dsohnaka/PTSG-WPMS-Formation/02_Reasoning_Traces/README.md

# Layer 2 — Reasoning Traces / 第2層——推論軌跡

**CC0.** The dialogues that produced Layer 1, published as Markdown (human) and JSON (LLM-ingestible). This profile sits between two other amanuenses (master: PTSG-CPU-Formation; customer: FPGA Spectrum Engine); their correspondence is part of the record.

| Trace | Date | Subject |
|---|---|---|
| `2026-09-07_wpms-formation-first-week` (.md / .json) | 2026-09-01 → 09-07 | Founding of the profile: charter and brief, the reading, the first rulings (W-R0–W-R9), the two discoveries that shaped the ISA (Stay value = packet length → two-stage register; integer ISA ⇒ program-owned MAC shift), deliverable 1, and the three-way correspondence. |
| `2026-09-27_mode-t-retraction-to-bundle-presentation` (.md / .json) | 2026-09-26 → 09-27 | Reading the customer's completed Layer 1; pricing CR5-L1, CR5-S1, CR5-I1; the two-window gap in F-F14; the model that sank Mode T; two remedies tested; bundle presentation with write windows; STP, BCP, the sweep sequencer; rulings W-R10 (amplitude) and W-R12–W-R17. |

Discrepancies filed upstream (four, all accepted and fixed 2026-09-03) and the customer's acceptance of deliverable 1 are recorded inside the trace.
