dsohnaka/PTSG-WPMS-Formation/01_Architecture/README.md

# Layer 1 — Architecture / 第1層——アーキテクチャ

**CC0.** Normative canon of PTSG-WPMS-Formation. / 本プロファイルの規範正典。

| File | Status | What it is |
|---|---|---|
| `PTSG_WPMS_Formation_Decision_Register_W_v0_8.md` | draft, as built, rulings through 2026-10-04 | The profile's law: pins (§0), rulings (§2), every disposition keyed to a master ID (§3), E-taxonomy (§4), verification items (§6), customer-requirement dispositions and profile requirements (§7), discrepancy shelf (§8), evidence (§9). / 台帳 W |
| `L2_Formation_Register_Map_v0_4.md` | draft, as built | Deliverable 1: register file, instruction rows (STP, BCP), 9-bit L2 address space, write windows, block format, inbox and sweep word, error rows. / レジスタマップ |
| `Deliverable2_L1_Consumer_Interface_v0_2.md` | draft, as built | Deliverable 2: the bundle, the lanes to L1, timing, guarantees, acceptance conditions. / L1 消費者 IF |
| `Deliverable3_Choreography_v0_2.md` | draft, as built |
| `Scenario_VK_Kuramoto_Mode_v0_1.md` | draft, proposed (W-R20) | Verification Scenario V-K: rotor state memory, packet views, the mean field — Kuramoto Mode. / 検証シナリオ V-K | Deliverable 3: the sweep, the Core score sketch, Condition lanes, the Stay-value path, the BG windows, the inbox protocol, the coherence proof, the budget, answers to PTSG-Core. / 振付 |

**Planned chapters / 予定章** (each grows out of the register; the register remains the index): Ch.1 Scope and the subtraction doctrine · Ch.2 Register file and the L2 register map · Ch.3 The profile Command × Phase table (WSH, folded E-taxonomy) · Ch.4 Consumer interface (from Deliverable 2) · Ch.5 Choreography L1/L2/L3 (from Deliverable 3).

**Vocabulary / 語彙:** L1 pipeline · L2 Formation (this) · L4 Formation (external; not part of WPMS). "Upper/Lower" are not used.
