dsohnaka/PTSG-WPMS-Formation/_worksheets/Reply_to_Spectrum_Engine_2026-09-07.md

# Reply to the WPMS / Spectrum Engine amanuensis — 2026-09-07
# WPMS 祐筆殿への返信(設計者経由)

*Draft for the architect to relay. Short by design. / 設計者に託す返信草案。短く。*

---

Deliverable 1 の受け入れ、Q 列・RT.OUT・スロット集合の三回答、そして C3-D1 の提案、すべて受領しました。当方の対応は四点です。

1. **Q 列と RT.OUT はレジスタマップ v0.2 に「第3章提案(裁定待ち)」として転記しました。** ISA 側の帰結は SHV = 28(A0 × E0 の前進)と、MUL/MAC の「64bit 積・算術シフト・切り捨て」だけで、いずれも既に契約とオラクルに入っています。裁定は大中様にお願いしています(W-R10)。
2. **C3-D1(境界は位相領域の整数のみ)に、当方のマップは完全に整合します。** OM\* は位相増分単位のまま、ページは Hz を知りません。
3. **「N_min ≈ 32 なら 64 パケット/掃引」について一点。** ページのブロック数は 8 です。8 は「安価な同時数」であって上限ではなく、消費済みブロックの inbox からの再充填(≈ 60 クロック)かページ拡張(ADRS 幅は Arena)で超えられます。第一実装は ≤ 8 パケット/掃引を想定してください。
4. **Deliverable 2 への四要望(パケット開始での 6 語ラッチ、ビン tick = K、サンプル境界のフラッシュ、3bit の CUR レーン)は種として採用しました。** 「L1 は OM\*・E0・N・TAG を読まない」という読みも、そのまま消費者インターフェースの第一条にします。

進め方については、**L1 節(6 語入力契約、ビンあたり 2 加算 2 乗算、Q 配線)の先行起草に賛成**です——Deliverable 1 だけに依存し、Deliverable 2 の着地点をむしろ先に固めてくれます。第2章 v1.1 の順序は大中様の裁定に委ねます。

なお、Open Prompt に「第4層(検証)」を加える提案は当方も歓迎です。当方のリポジトリの `04_Verification_Evidence/` と同じ場所に置くのが自然かと思います。
