dsohnaka/PTSG-WPMS-Formation/04_Verification_Evidence/reports/discrepancies.md

# Discrepancies — silicon phase / 食い違い台帳——シリコン化段階

*CC0 · Layer 4 register of disagreements found while executing `SILICON_BRIEF_2026-09-27.md`. Opened in Phase 0 (2026-09-27).*
*Rule (brief §6, CLAUDE.md): every row records what the texts say, what was found, and a proposed disposition — **filed, not fixed**. No Layer 1 document, golden model or frozen Core source has been edited to resolve any row. The architect rules.*

*規則（指示書 §6）: 各行は「文書が言うこと・見つけたこと・処置案」を記す——**記録のみ、修正なし**。いずれの行についても、第1層文書・黄金モデル・凍結 Core は一切編集していない。裁定はアーキテクト。*

Evidence classes: **ORACLE** (Python model) · **RTL-SIM** (Icarus) · **SILICON** (DE10-nano). "Reading" = found by reading the RTL/texts, not yet exercised.

---

## Summary / 一覧

| ID | Item | Texts say | Found | Proposed disposition | Class · state |
|---|---|---|---|---|---|
| **SD-01** | Band on the issue port (brief known #1) | master Ch.5 §5.2 lane 1, §5.3: the issue carries {mode, sub-op, operand, **band**} | `ptsg_core.v` RH030 exports `ext_op_valid`, `ext_op_subopcode[3:0]`, `ext_op_sub_operand[7:0]`, `ext_op_data[15:0]`, `ext_op_ready`; **no band** (`window_open`, `in_queued_band` internal) | E2 stays validator-only in the silicon phase (brief, Phase 2); band export is a Core-office item at its checkpoint; no Core change | Reading · open |
| **SD-02** | FG silence of the issue port (IF-3) | master Ch.5 §5.3 **IF-3**: C3-F23 halts any Global in FG, so the issue port never fires with band = FG and E1 is enforced by the Core | The RTL's FG trap covers only internal Base Set / Return / Call / Loop / Prog End. An **external-mode Global in FG is issued** (`ext_op_valid` has no window term) and advances at full clock, no HALT | Architect to rule: C3-F23 covers mode ≥ 1 (Core halts them at a checkpoint) **or** IF-3 is amended (E1 validator-only, like E2) | Reading · open |
| **SD-03** | SSS source (brief known #2) | master Ch.2 §2.6b, §2.9 (source ID 6); Ch.5 §5.2 lane 4, §5.4, **INT-R4**: Stay Start State + window-start event observable; Map v0.3 §2 | `stay_start_state` is internal ("no Core-level external visibility", C3-F25); **no port, no window-start event**; internal Globals (incl. Stay Set) are not issued on the ext bus | Phase 2 records a documented substitute for source ID 6; INT-R4 stays open with the Core's office. No WPMS program reads SSS today. *Phase 2 substitute: input `tap_sss[11:0]` of `wpms_formation.v`, driven in Phase 3 by the L2 top with the window label it latches at Stay Set* *Phase 3: the sequencer latches the Stay Set's address at every Stay Set (the value the Core's `stay_start_state` takes, C3-F25) and drives `tap_sss` with it from the window's first instruction on.* | Reading · open (substitute in place, Phase 3) |
| **SD-04** | Gap-free data-driven re-entry, R2 (brief known #3) | W v0.7 **W-R17** (R2 preferred); D3 §3 (backward transfer at timeup, or a loop count as data); Core commitment g = 0 | A queued Loop never performs the indirect read (`need_ind_loop` excludes the Q band; queued Loop(0) = zero iterations, C4-V1); the Q band admits one SN reservation (C3-F26; a second HALTs, T21). A queued Base Set + Loop gives a gap-free backward re-entry **with a literal count only** | Preliminary: no data-driven gap-free R2 in the Core as built. Phase 3 confirms by simulation, reports the Hook A options, proceeds with R1 (brief). No Core change *Phase 3 (`r2_probe.py`, RTL-SIM): queued Base Set + queued Loop 3 re-enters the whole window gap-free (Stay Set to Stay Set 32, 32, 32); queued Loop 0 plays once and makes no indirect read. R2 not built; Hook A answer in the Phase 3 report.* *2026-09-29: no INT-R1 request to the Core's office for now — the dispatch form already gives g = 0 and is the standard score; LoopVal stays on the indirect-read bus for a future data-driven loop.* | **Ruled 2026-09-29**: INT-R1 not requested now; R2 not built · closed |
| **SD-05** | Forward conditional at timeup (R1) and the NONEMPTY check vs Core Branch law | D3 §3: R1 "forward conditional: MORE → PKT(q+1), else → HK; needs only forward transfers"; sketch "Branch +→HK, lane NONEMPTY, false → HK [1 clock]" | Core Branch: Condition true → no branch (C2-F5); **taken → auto-save** into the holding register (C2-F6); a second save while it is occupied goes through **S_PUSH and waits for `stack_ack`** (C3-T6). Queued Branch **not taken resumes at Branch + 1** (T16), inside the Q region, not at Stay + 1 | Phase 3 designs the score around these laws and measures g; architect ruling may be needed on the queued-Branch not-taken resume address (§3.4b Branch Q row). Not a Core change. *Phase 2: both consequences reproduced by the score round trip (`score_rt.py` RT-1, RT-3)* *Phase 3: the score avoids both consequences — dispatch form (R1-D): no conditional transfer at all (queued Jumps, entry chosen in housekeeping by a background computed dispatch); branch form (R1-B): foreground Branch after each Stay (g = 1) and a foreground Reset closing housekeeping.* *2026-09-29: the dispatch form is the standard score for Phases 4–6 (ruling); it makes no conditional transfer, so neither consequence arises in it.* | RTL-SIM · open (worked around; not met by the standard score) |
| **SD-06** | Formation error strobe (lane 8, INT-R2) | master Ch.5 §5.2 lane 8, §5.8: the strobe "rides the Core's external error/halt input" (**INT-R2**); Map v0.3 §8: EW2–EW6, E4, E5 → Error HALT | `ptsg_core.v` has `error_flag` (output) only; **no external error/halt input** | Phase 2 picks insertion or Condition per C3-F24 and documents it (brief); INT-R2 stays open. *Phase 2 chose insertion: `insert_req` → `TRAP_ADDR`, where the score places a foreground Prog End (C3-F23 → C3-F24 HALT); Core wiring and latency measured in Phase 3* | **Ruled 2026-09-28**: insertion approved; L1 is silenced at once by the Formation's `error_flag`, without waiting for the Core's HALT (Phase 3) · INT-R2 stays open. *Phase 4: an error in the first housekeeping window after reset left JumpVal at its power-up 0, the dispatch went to 0x000 inside the open window and the deferred insertion was never taken (no HALT; L1 silent all the same). Fixed on the Formation side: JumpVal powers up at the score's TAIL_0 (`wpms_formation.v` RH003, `wpms_l2_top.v` RH002); now HALT 11 clocks after the flag* |
| **SD-07** | Width of I | Map v0.3 §1, §2: quartet K / I / SN / SSS is **W12** | Core `LOOP_W` = **16** (architect ruling 2026-07-07); `loop_counter[15:0]`; master Ch.2 §2.2 "I … loop-counter width" | Phase 2 reads I as 16 bits, zero-extended; Map to be aligned by ruling | Reading · open |
| **SD-08** | Register W v0.7 §2.2 editorial | §2.2 "Open: None." | A stray table fragment (file lines 80–86) repeats W-R12…W-R17 in their v0.6 "open" form; its W-R17 row ("R1 or R2 — the Core's choice") contradicts §2.1 | Editorial cleanup at the next version; no effect on the build | Reading · open |
| **SD-09** | Customer Appendix 5.B mask presets | Ch.5 §5.4.2 "bit 16 = RT.OUT"; §5.6.2 COMMIT[b] [16]; App. 5.B "RETUNE 0x9E3B … + RT.OUT", "RESEED 0x9FFF … + RT.OUT" | Neither value has bit 16 set (with it: 0x19E3B, 0x19FFF) | Customer to correct value or wording (via the architect, PR-5 style); the Phase 5 host script sets bit 16 explicitly | Reading · open |
| **SD-10** | Stale header comments in `ptsg_core.v` not covered by the RH029/030 patch | Core Ch.3 §3.2 (C4-F10 corrected: counter counts On-Tick from Stay Set through the window); Core README tie table | Header Tie line "C4-T4 … the stay counter ticks only during the wait" contradicts C4-F10; "Deliberate simplifications" still says post-Prog-End commands other than Loop execute immediately (superseded by RH014–RH019) and that imem is an asynchronous read (superseded by `ptsg_imem` NEG) | For the Core's office at its checkpoint (comments only). **Not** changed in the working copy — outside the brief's patch list | Reading · open |
| **SD-11** | Registered timing signals vs "packet_start = Stay Set ∧ TS_PKT" | D2 §2–§3: `packet_start` = Core Stay Set ∧ TS_PKT, K = 0 **on that clock**; `bin_valid` = TS_PKT held through the Stay | `timing_signals` is a registered Core output: a word's D16–D31 appears **one clock after** the word executes (FG Stay Set: `timing_signals <= tsig`). During the Stay Set clock the bus still shows the previous word's bits; TS_PKT alone therefore rises one clock late at the first packet and falls one clock late after the last (the housekeeping Stay Set clock) | Phase 3 derives `packet_start`/`bin_valid` so that they align with K = 0 on the Stay Set clock (e.g. from `state_number` against the score's packet addresses, or a documented one-clock shift of L1) and states the choice *Phase 3: resolved by a uniform one-clock L1 face — bin_valid(c) = TS_PKT(c), K(c−1), packet_start one clock after the Stay Set; every packet of the sweep cosimulation has N bins with K = 0 … N−1.* | RTL-SIM · resolved in the L2 top (Phase 3) |
| **SD-12** | Packet floor on the Core: 29 (nominal) vs 30 (RTL-SIM) — *Phase 1* | D3 §6.1, Map v0.3 §9, `wpms_packet.pfasm` header, `sweep_sim.py` output: 25 window instructions + **4** Core clocks = 29, rounded up to N_MIN = 32 | On the Core copy, a windowed Stay never times up in its execute clock (RH028's same-clock timeup is for bare Stays only), so Stay Set · 25 · Prog End · queued transfer · Stay needs **one S_WAIT clock more**: period = max(N, **30**), K = 0…N−1, g = 0 (SV-5b) | The RTL number replaces the nominal in the reports (not in Layer 1, which changes by ruling); N_MIN = 32 still holds with 2 clocks of margin. Phase 3 re-measures with the real window and score (an R2 body with Base Set(Q) + Loop(Q) would add one more clock: 31, by reading) *Phase 3, with the real window and score: floor 30 in the dispatch form (N = 28, 29, 30 → 30; 31 → 31), max(N, 29) + 1 in the branch form.* | RTL-SIM · open (re-measured, Phase 3) |
| **SD-13** | E8 for a left SFT that leaves 32 bits — *Phase 2* | Register W v0.7 §4 row E8 "MUL/MAC only (W-F30)"; W-F30 "E8 only for MUL/MAC"; Map v0.3 §3 1·7 SFT "master semantics", §8 E8 "MUL/MAC overflow"; master Ch.3 E8 "arithmetic overflow … never lost" | The golden model raises **E8 for SFT** too: `Machine.run` SFT → `sat(accm << -n)` (line 178). The hardware follows the model (golden, never edited to make hardware pass); mutant M17 shows the cosimulation tells the two apart | Architect to rule the reading of "only": (a) "not ADD/SUB" — SFT keeps the master's never-lost rule, texts read "MUL/MAC/SFT" (model and hardware stand); (b) SFT left shifts wrap or saturate silently — model and hardware change together | **Ruled 2026-09-28: (a)** — E8 on SFT overflow stands; the texts to say MUL/MAC/SFT at their next version (Layer 1 not edited here) |
| **SD-14** | Lane select of a foreground Branch is one word late — *Phase 2* | Deliverable 3 §4: the Condition lane is "selected by two timing-signal bits of the word being executed (or held)"; §3 sketch: SLEEP `Branch 0` (STROBE) then `Branch +→HK` (NONEMPTY) | `timing_signals` is registered (as SD-11): in the clock a foreground Branch evaluates `condition`, the bus still carries the **previous** word's bits. `score_rt.py` RT-2 (P = 2): the NONEMPTY Branch at 0x002 is evaluated with SLEEP's CSEL = STROBE (strobe already low) and goes to HK — every sweep plays empty. Queued Branches at timeup are not affected (the held Stay word's bits are current) | Phase 3 chooses one, and states it: (a) put the lane's CSEL on the word *before* the Branch (e.g. `NOP CSEL=NONEMPTY` after SLEEP: T_wake 2 → 3, still ≤ 4 — RT-3 runs this variant); (b) decode the lane from `state_number` in the sequencer. No Core change | **Ruled 2026-09-28: (a)** — the lane's CSEL rides on the word before a foreground Branch; T_wake 3 accepted (bound 4) |
| **SD-15** | Insertion handshake: the Core takes a still-held request twice — *Phase 3* | Core Ch.5 §5.9: `insert_req` is a level, held until `insert_ack`; "External logic should deassert `insert_req` no earlier than the clock in which it sees `insert_ack`" | `insert_ack` is registered: it shows one clock after the Core accepted. In that clock the Core, in S_RUN outside a window (at the trap word), sees `insert_req` still high and accepts it again; the second auto-save finds the holding register occupied and waits in S_PUSH for `stack_ack` — the Core never reaches its HALT. Found by the Phase 3 error injections; the Core's own testbench drops the request in the ack clock (T5a, T23), which is the only safe reading | The Formation withdraws `insert_req` combinationally while `insert_ack` is high (`wpms_formation.v` RH002; mutant S10 shows the case is covered). For the Core's office: the text could say "deassert in the clock `insert_ack` is high", or the RTL could ignore `insert_req` while `insert_ack` is high. No Core change. *2026-09-29: reproduced on the frozen source with a six-word program (`rtl_sim/2026-09-29_sd15_insert_handshake/`, `hw/core/run_sd15.sh`: 24 of 24 runs as recorded).* | **Ruled 2026-09-29**: the Formation workaround (RH002) approved; conveyed to the Core's office as a bug report for a later fix: [dsohnaka/PTSG-Core#5](https://github.com/dsohnaka/PTSG-Core/issues/5) · open with the Core's office |
| **SD-16** | The Maclaurin core: Ch.2 v1.1's format table vs its own error budget; no oracle for sin — *Phase 4* | Customer Ch.2 v1.1 §2.4.1 (constants C₃…C₁₁ and every Y in Q1.26; x′ Q2.25; X Q4.23), §2.5.1 ("Y₁ = C₉ − X·C₁₁, pre-scaled"), §2.8.2 (ε ≈ 1.3×10⁻⁷), C2-D10 (7 DSP); §2.3.3 ("bit inversion … equivalent to two's complement negation modulo 2⁻²"); §2.2.1 ((π/2)¹³/13! ≈ 4×10⁻⁸). The customer's oracle models phase, exp2, amplitude and glide — **not sin** | Taken literally, the table puts C₁₁ = 1/11! at **2** LSB of Q1.26 and C₉ at 185 (8 significant bits): max error **3.97×10⁻⁷ = 2⁻²¹·³** (ORACLE, 200,000 phases) — 3× the budget. Two's complement "reflection" gives sin = 0 at φ = ¼ (mutant S1). (π/2)¹³/13! = 5.7×10⁻⁸ | The Arena realization published in `hw/tools/l1_model.py` (and `hw/l1/wpms_l1_sin.v`, bit for bit): Horner in U = u² with u the in-quadrant phase in cycles, (2π)^(2j+1)/(2j+1)! folded into the coefficients (§2.9 "folded" row), a power-of-two scale per stage (§2.5.1 "pre-scaled"), 7 multipliers, 16 clocks, truncation toward zero, reflection by bit inversion: max error **2⁻²⁴·⁰** (exhaustive over u, ORACLE) — the 11th-order truncation itself. Customer to consider: the table's Y/constant formats as per-stage scales; the reflection wording; a sin model in the oracle | **Ruled 2026-09-30**: the Arena realization is the L1's sin definition; the note for the customer is prepared (`reports/customer_note_sd16_sin.md`) · ORACLE, RTL-SIM · open with the customer |
| **SD-17** | The test origin at NMAX = 1,008 — *Phase 4* | Customer Ch.3 §3.10 and Ch.5 §5.8: the ROM's test origin is one block with **N = 2,048**; ruling 2026-09-29: **NMAX = 1,008** at 50 MHz | At NMAX 1,008 the ROM's sweep word lists a block whose N exceeds NMAX: BCP refuses it with **EW5** (Σ N > NMAX) in the first housekeeping window — L1 silent, the Core halts at the trap (`cosim_synth.py grid --case origin_literal`, RTL-SIM). The first sound of Ch.5 §5.8 cannot play at 50 MHz as written | Architect to rule the 50 MHz ROM image: (a) N = **1,008**, every other integer as §3.10 (RTL-SIM: plays bit-exact; PCM peak −12.44 dBFS at G = 12, against −6.3 for N = 2,048); (b) keep N = 2,048 and the test origin only on a 100 MHz build; (c) a 60 MHz clock (the architect's note of 2026-09-29) does not reach 2,048 either | **Ruled 2026-09-30: (a)** — the 50 MHz ROM image plays the test origin with N = 1,008; the 100 MHz image keeps 2,048 (Phase 5 builds both) · closed |
| **SD-18** | The sweep oracle's full-load traffic at NMAX = 1,008 — *Phase 4* | `sweep_sim.py` writes "full-load GO: sigma N = NMAX exactly" by cutting NMAX // N_MIN units of N_MIN | 1,008 is not a multiple of 32: its full-load GOs reach Σ N = **992**, so the oracle's traffic never loads a 50 MHz sweep to NMAX (none in the Phase 4 runs). Not a defect of the model for NMAX 2,048 | Covered by a directed case (`--case full8`: 8 × 126 = 1,008 bins, RTL-SIM). The golden model is not edited; a generator using NMAX exactly would close the gap, if wanted | Reading · informative |
| **SD-19** | The host path: ISSP carries the writes — *Phase 5* | Customer Ch.5 §5.7 and C5-D8 (Fixed): writes through "a JTAG-reachable memory-mapped master on port 0" (reference: the JTAG-to-Avalon master bridge; a Virtual-JTAG custom protocol is the Arena alternative); "ISSP stays required, for probes and a few direct knobs … ISSP is no longer the parameter write path"; the brief's Phase 5: HPS bridge or UART | Architect's ruling of 2026-09-30: the Phase 5 host path is **ISSP over JTAG**, read and written by hand from the Quartus editor. Realized so that nothing of the map changes: the ISSP instance HOST carries **addressable port-0 transactions** of §5.6 (ADDR 12 + WDATA 32 + a write and a read toggle; RDATA and acknowledges on the probe) — an addressable write path in the Virtual-JTAG family, the Arena alternative's kind; ISSP keeps its probe role (instances STAT, INSP) | For the customer, via the architect: §5.7 / C5-D8 to admit ISSP as a transport of port 0 (or to list it with the Arena alternatives); the map, the ports and stage-arm-go are unchanged | **Ruled 2026-09-30** (architect); **2026-10-01: adopted** as the profile's host path, and the customer may be told that the profile overrides C5-D8 here (note prepared: `reports/customer_note_sd19_host_path.md`) · RTL-SIM · closed for the profile; with the customer (information) |
| **SD-20** | The ROM's list against ownership — *Phase 5* | Ch.5 §5.8: the ROM (port 3) writes module 0 block 0, its SWEEP, MG_TARGET and "all owners = port 0", ending in GO_ALL; §5.5.2: a write, arm or GO from a non-owner is refused; owners are set only from ports 0 and 3; "changing an owner disarms that item" | Taken together, the ROM cannot write blocks that port 0 owns, and if it sets "all owners = port 0" before its GO_ALL it disarms its own items — unless port 3 is exempt from ownership for its own list, which the text does not say. The minimal switch builds ports 0 and 3 only, both privileged: OWNER is stored and read back but **not enforced** (enforcement matters once port 1 or 2 exists) | Customer to state the ROM's standing: port 3 exempt from ownership for its list (proposed), or the owner writes first and no disarm for the ROM's own items | **Ruled 2026-10-01**: port 3 (the ROM) is **exempt from ownership** for its own list. Nothing changes with ports 0 and 3 (OWNER is not enforced); when port 1 or 2 brings enforcement, it skips port 3 · closed |
| **SD-21** | "Armed" means two things — *Phase 5* | Ch.5 §5.4.2: "arm" is the writer's step before GO; Map v0.3 §7: at each strobe the sequencer latches the take-set, "the blocks and sweep item **armed** at that moment" | In the profile the Formation's armed flags must mean **handed over by a GO**, else an armed-but-not-fired item would be taken without GO. Realized: the switch keeps the writer's arm and hands the fired set over in one clock (Formation RH004, inbox port 0x9F: a strobe takes all of a GO or none). Found by the Phase 5 timing case: with a registered hand-over, a GO accepted in the clock before a strobe missed that strobe and played from the third (2 periods + 1 clock, against §5.4.3's ≤ 2); RH004 also lets the strobe take an arm write presented in its own clock — now every GO plays from the second strobe after its acceptance | Map v0.3 §7 wording at the next version: "the items handed over (fired) at that moment, including a hand-over in the strobe's own clock" | **Ruled 2026-10-01**: RH004 approved; Map §7's wording changes at the Map's next version (the wording above) · RTL-SIM · closed (realized); the wording waits for the Map's next version |
| **SD-22** | clk_sys does not close at 50 MHz — *Phase 6* | Brief Phase 6: "100 MHz; timing closure"; ruling 2026-09-28: 50 MHz if 100 MHz is at all difficult, "no pipelining of the long paths now; timing optimization after correct operation"; ruling 2026-09-29: NMAX 1,008 at 50 MHz; Phase 2's clock table: each Formation instruction is read, computed, checked and committed — the store write included — in its X clock, one per clock, never stalled (IF-1) | First Quartus fit (2026-10-03, revision DE10_Nano_wpms, 5CSEBA6U23I7, slow corner): clk_sys setup **−14.307 ns** against 20 ns, TNS −65,525 ns; every other clock meets. The X clock chains the address decode, the forwarded store read, the 32 × 32 MUL/MAC with shift and add, the overflow, the error priority, the one x_commit, the store's write enables (≈ 4,100 flip-flops) and the background copy's pending logic (gate depth 146). Its tail from the multiplier into the store, the copy and the pending masks is **structural only** (STM and STA @PPM, the only store writers, and BCP have errors that do not depend on the multiplier). Real long paths: MUL @PPM into Accm; BCP's EW5 (a chained eight-term sum of N) into inbox_taken; the switch's GO check (a chained sum of N; depth 99) | In RTL, in two steps, each followed by the Phases 2–6 recipes (window floor 30, BCP 10, T_wake 2, bit-exact bundles and banks) and a new fit. **Step 1, behaviour unchanged** (no clock added): each register's enable from its own instruction's error conditions; the address decode registered with ADRS; the sums of N as adder trees (Formation RH005, switch RH002). **Step 2, only if step 1 does not close**: a write-back clock for Accm, Temp and the store, E8 checked there, forwarding, BCP and the copy in their clocks — a pipeline, so it needs the 2026-09-28 ruling lifted. Not proposed: a multicycle exception, a slower clk_sys. The failing-path report first (`hw/de10_nano/report_setup_paths.tcl`) | STA (Quartus 23.1std.1) · **Ruled 2026-10-03**: step 1 now; step 2 without a new round if step 1 does not close · step 1 realized (Formation RH005, switch RH002); the second fit −6.976 ns · step 2 realized (Formation RH006, switch RH003; E8 of MUL/MAC and an EW2 in their X clock one clock later, same code and SN; all else unchanged: lockstep RTL-SIM, SAT) · **the third fit (2026-10-04) closes clk_sys: +0.978 ns, TNS 0 — resolved for the 50 MHz revision** |
| **SD-23** | The Core's imem half-cycle path at 50 MHz — *Phase 6* | The frozen `ptsg_imem.v` (EDGE "NEG") and the Core's DE10-nano README: the path M10K (falling edge) → decode → the FSM's registers (next rising edge) is a half-cycle path, "comfortable" and "non-binding at 50 MHz" (M10K Tco ≈ 2.4 ns plus decode, against 10 ns); if it ever binds, the remedies are "RTL-side (EDGE=\"POS\" + fetch stage) or a faster speed grade — not SDC relaxation" | Second fit (2026-10-03): **113 Core endpoints fail, worst −2.028 ns** (`state_num`; `loop_cnt` −2.018). The word leaves the M10K 1.06 ns after its clock and crosses 10 LUT levels of the Core's own next-state logic (`Decoder0 → WideOr7` ×4 → `state_num`), 10.70 ns, against the 10 ns half period; clock skew −1.245 ns, the M10K's internal clock delay (1.518 ns) being on the launch side. Placement is already local. The RH031p copy is the Core here; this path is the Core's decode, not a WPMS addition | Core and wrapper untouched. In the third fit, clk_sys runs **30 % high** in the 50 MHz revision (`SYS_DUTY`; wpms_pll RH002, the board top RH002, make_quartus_project RH003): the falling edge 6 ns after the rising one gives the imem's read 14 ns; the address side (`state_num`, a register straight into the M10K's address register) keeps 6 ns. STA analyzes the real waveform; no exception. `--sys-duty 50` restores the clock of the first two fits. The alternative is the Core's documented migration (EDGE "POS" + a fetch stage), a Layer 1 matter (C2-T4) | STA · applied in the third fit, which closes (the Core's paths are not among the 10 worst: slack ≥ +1.547 ns) · **Ruled 2026-10-04: (a), 30 % high, adopted** |

Rows added in later phases are appended below the Phase 0 set (SD-12 from Phase 1; SD-13, SD-14 from Phase 2; SD-15 from Phase 3; SD-16 … SD-18 from Phase 4; SD-19 … SD-21 from Phase 5; SD-22, SD-23 from Phase 6).

**Rulings received 2026-09-28 (architect) / 裁定（2026-09-28）:** SD-13 (a); SD-14 (a); SD-06 insertion approved, with L1 silenced at once by the Formation's `error_flag`; **clock target**: schedule first — if 100 MHz is at all difficult the target becomes **50 MHz**, with the per-sweep budgets (NMAX and the rest) halved; no pipelining of the long paths now; timing optimization after correct operation. / SD-13 は (a)、SD-14 は (a)。SD-06 は挿入方式を承認し、L1 は Formation の `error_flag` で即座に無音化。クロック目標は日程優先で、100 MHz が少しでも難しければ 50 MHz（NMAX 等は半分）。長経路のパイプライン化は今は行わない。 / 以降の段階で見つかった行は Phase 0 の組の下に追記する（SD-12 は Phase 1、SD-13・SD-14 は Phase 2、SD-15 は Phase 3）。

**Rulings received 2026-09-29 (architect) / 裁定（2026-09-29）:** (1) the **dispatch form** of the R1 score (`wpms_r1d`) is the standard score for Phase 4 and after; (2) **NMAX = 1,008 at 50 MHz** (if 1,024 is ever needed, a PLL at 60 MHz leaves room); (3) SD-04: **no INT-R1 request** to the Core's office for now — g = 0 is met by the dispatch form; (4) SD-15: the Formation's workaround is approved; the item goes to the Core team as a **bug report** for a later fix; (5) **LoopVal stays connected** to the Core's indirect-read bus (purpose 01), for future data-driven loops. / (1) R1 楽譜のディスパッチ形を Phase 4 以降の標準とする。(2) 50 MHz の NMAX は 1,008（1,024 が要れば PLL で 60 MHz の余地）。(3) SD-04: INT-R1 の要求は当面見送り。(4) SD-15: 回避策を承認し、Core チームへ不具合報告として伝える。(5) LoopVal は間接読出しバスに接続したまま。

**Rulings received 2026-09-30 (architect) / 裁定（2026-09-30）:** (1) SD-17 **(a)**: the 50 MHz test origin plays with N = 1,008; (2) SD-16: the Arena sin realization is the **official specification** of the L1's sin; a note for the customer team is to be prepared; (3) ADV7513: the architect supplies the documents — the data sheet (Rev. B) arrived first; the whole programming guide could not be uploaded (and `www.analog.com` and `ez.analog.com` are denied by this session's network policy), so the architect sent extracts of the Programming Guide Rev. B the same day: every value of the table agrees with the pages, 0x0C[7] is set back to the guide's default (the configurator's RH002), and four fields stay [R] for the board (phase5_switch.md §3.10); (4) the Phase 4 choices where the texts are silent (phase4_l1.md §4.4) are **all approved**; (5) the **second module** (Compact) is added only after the Phase 6 silicon run with one module has fully succeeded; (6) **Phase 5 host path changed**: instead of the brief's "HPS bridge or UART", Intel's **In-System Sources and Probes (ISSP) over JTAG** — a deterministic controller for white-box verification is allowed, with the ISSP bits **OR-connected** to it, so that inbox slots, masks, RT.OUT, the sweep word, ARM and GO can be read and written directly from the Quartus GUI; the simplest, most robust JTAG debug interface. / (1) SD-17 は (a)：50 MHz のテスト原点は N = 1,008。(2) SD-16：sin の独自実現を L1 の正式仕様とし、顧客チームへの報告を準備する。(3) ADV7513：データシート（Rev. B）がまず届き、ガイド全体はアップロードできなかった（両ホストもネットワーク方針で遮断）ため、同日にプログラミングガイド Rev. B の抜粋を受領。設定表の値はすべて頁と一致し、0x0C[7] をガイドの初期値に戻した（設定器の RH002）。未確認 [R] は 4 フィールドのみで、実機で読み返す（phase5_switch.md §3.10）。(4) Phase 4 §4.4 の選択はすべて承認。(5) 2 つ目のモジュールは 1 モジュールでの Phase 6 実機検証の完全な成功の後。(6) Phase 5 のホスト経路を変更：HPS ブリッジ／UART に代えて ISSP（JTAG 経由）。白箱検証用の決定論的コントローラは可、ISSP のビットはそれに OR 接続し、Quartus の GUI から inbox スロット・マスク・RT.OUT・掃引語・ARM・GO を直接読み書きできる、最も簡素で堅牢な JTAG デバッグ口とする。

**Rulings received 2026-10-01 (architect) / 裁定（2026-10-01）:** (1) SD-21: Formation **RH004 approved** (the hand-over vector and the take of a hand-over in the strobe's own clock); Map §7's "armed" may be redefined at the Map's next version; (2) SD-19: the addressable ISSP transactions are **formally adopted** as the host path; the customer may be told that the profile overrides C5-D8 here; (3) SD-20: the ROM (port 3) is **exempt from ownership**; (4) the Phase 5 choices where the texts are silent (phase5_switch.md §4.4, C-1 … C-15, C-1 and C-8 included) are **all approved**; (5) **Phase 6** (DE10-nano silicon) begins. / (1) SD-21：Formation の RH004（引渡しベクトル、ストローブ同クロックの引渡しの取込み）を承認。Map §7 の「armed」の定義は次版で改めてよい。(2) SD-19：ISSP のアドレス付きトランザクションをホスト経路として正式採用。顧客には C5-D8 をこちらで上書きした旨を伝えてよい。(3) SD-20：ROM（ポート 3）は所有規則の適用外。(4) Phase 5 §4.4 の選択 C-1〜C-15（C-1・C-8 を含む）はすべて承認。(5) Phase 6（DE10-nano 実機）へ進む。

**Ruling received 2026-10-03 (architect) / 裁定（2026-10-03）:** SD-22 — **step 1** (restructuring, behaviour unchanged) is to proceed now; if step 1 does not close timing, **step 2** (the write-back clock) follows **without a new round of questions**. This lifts, for step 2, the 2026-09-28 "no pipelining of the long paths now". / SD-22：段階 1（動作不変の再構成）を直ちに進める。段階 1 で収束しなければ、改めて問わずに段階 2（書戻しクロック）へ進む。段階 2 については 2026-09-28 の「今は長経路をパイプライン化しない」を解除する。

**Phase 6, part 1 (2026-10-01): no new item.** The board top on the board-level bench agrees with the models and with the brief's bounds at both budgets. The findings that are not discrepancies are in `phase6_silicon.md` §4.2, among them: BCP takes exactly its bound (10 clocks) with the full take-set; the Core's halt after an error inside a packet window waits for the end of that packet's Stay, while L1 is silent from the flag on; the pixel PLL is fractional; the sweep's length has two readings, both within T_min. The silicon captures may add rows. / **Phase 6 その 1（2026-10-01）：新規項目なし。** 基板レベル試験台のトップは両予算でモデルと指示書の上限に一致した。食い違いではない所見（全取込みの BCP がちょうど上限の 10 クロック、窓内エラー後の HALT はそのパケットの Stay の終わりを待つが L1 はフラグ時点から沈黙、画素 PLL は分数型、掃引長の 2 つの読み方はいずれも T_min 内、など）は `phase6_silicon.md` §4.2 に記した。実機取得で行が加わりうる。

---

## Details / 詳細

### SD-01 — Band on the issue port / 発行ポートの帯域

- **Texts.** Master Ch.5 §5.2 (lane 1 "Issue port {mode, sub-op, operand, band} + valid"), §5.3 ("the Core presents {mode, sub-op, operand D16–D31, current band}"), §5.8 (E2 is Formation-detected).
- **Found.** Frozen `ptsg_core.v` (sha256 `fb995687…60e0`), port list: `ext_op_valid`, `ext_op_subopcode` (= D4–D7), `ext_op_sub_operand` (= D8–D15), `ext_op_data` (= D16–D31), `ext_op_ready` (captured, never stalled on). The band exists only as internal `window_open` / `in_queued_band`.
- **Consequence.** E2 (Formation instruction in the Q band) cannot be detected by the Formation from the bus.
- **Disposition (proposed).** As the brief directs: E2 remains the validator's (`pfasm_tools_w.py`) in the silicon phase. Exporting a two-bit band is a Core-office item. No Core change.
- **和文.** マスター第5章は発行に帯域を含めるが、凍結 Core の外部演算バスには帯域がない。Formation はバスだけでは E2 を検出できない。指示書どおり E2 は検証器に委ね、Core は変更しない。

### SD-02 — Foreground silence of the issue port (IF-3) / 発行ポートの前景沈黙

- **Texts.** Master Ch.5 §5.3 IF-3; Core Ch.3 §3.4b C3-F23 ("Global commands do not execute in the foreground, with exactly three justified exceptions" — the listed window-only commands are internal sub-ops).
- **Found.** `ext_op_valid = (fsm == S_RUN) && is_external_global && !insert_pending` — no window term. In `S_RUN`, `OP_GLOBAL` with `g_mode != 0` executes `state_num <= state_num + 1` in every band, untick-gated. Only internal Base Set / Return / Call / Loop / Prog End reach `halt` in FG.
- **Consequence.** A Formation instruction placed in the foreground is issued and executed; E1 is enforced by neither side.
- **Disposition (proposed).** Architect to rule on the reading of C3-F23 for mode ≥ 1. Until then E1 is validator-only in the silicon phase, like E2.
- **和文.** IF-3 は「C3-F23 が前景の Global を止めるので発行ポートは FG では発火しない」とするが、RTL は内部サブオペ5種のみを止め、前景の外部モード Global は発行・前進する。E1 はどちらの側でも執行されない。C3-F23 の適用範囲の裁定を求める。

### SD-03 — SSS source / SSS ソース

- **Texts.** Master Ch.2 §2.6b ("a Formation-latched copy taken at window start"), §2.9 (source ID 6); Ch.5 §5.4 and INT-R4; Register Map v0.3 §2.
- **Found.** `stay_start_state` is an internal register; README and Core Ch.3 C3-F25: "no Core-level external visibility; a Formation may copy it to a general register". No port carries it, and no window-start (Stay Set) event leaves the Core (internal Globals are not issued).
- **Consequence.** Source ID 6 cannot be the Core's register latched at window start. `wpms_packet.pfasm`, `wpms_housekeeping.pfasm` and `exp_maclaurin_w.pfasm` do not read SSS.
- **Disposition (proposed).** Phase 2 implements source ID 6 with a documented substitute and says exactly what it returns; INT-R4 remains open.
- **和文.** Core は Stay Start State を外へ出さず、窓開始イベントもない。ソース ID 6 は仕様どおりには実現できない。Phase 2 で代替を明記して実装し、INT-R4 は Core 事務所に残す。

### SD-04 — R2 without a gap / R2 の無間隙再入

- **Texts.** Register W v0.7 W-R17; Deliverable 3 §3 (R2: "a conditional backward transfer at timeup, or a loop count supplied as data (P)"); Core commitment g = 0 (D2 §3; W §2.1).
- **Found (reading).** `need_ind_loop = … && !in_queued_band && window_open`: a queued Loop is never resolved through `indirect_purpose` 01; its literal D16–D31 is its count, and 0 means zero iterations (C4-V1; README "Deliberate simplifications"). One SN reservation per Q band (C3-F26, RH023, T21). A queued Base Set loads Base := Stay Start State (C3-F25, T28/T32), so `Stay Set … Prog End · Base Set(Q) · Loop(Q) · Stay` re-enters its own Stay Set at timeup without a gap — with a **literal** count.
- **Preliminary conclusion.** No data-driven, gap-free R2 in the Core as built. To be confirmed in Phase 3 by simulation; options reported against Hook A of the 2026-09-27 trace; R1 used for bring-up.
- **和文.** キュー帯域の Loop は間接読みを行わず（直値のみ）、Q 帯域の予約は一つ。Base Set(Q)+Loop(Q) で無間隙の後方再入はできるが回数は直値。データ駆動の無間隙 R2 は現行 Core にはない見込み。Phase 3 で模擬して確定し、選択肢を報告、R1 で進む。

### SD-05 — R1's forward conditional and the NONEMPTY check / R1 の前方条件遷移と NONEMPTY 判定

- **Texts.** Deliverable 3 §3 (sketch and R1); Deliverable 2 §3 (g = 0).
- **Found (reading, and the Core's own conformance tests).** `branch_decide`: Condition true → `state_num + 1`; operand 0 → self-loop, no save; otherwise `save_or_set(state_num, …)`, i.e. an **auto-save** (C2-F6). With the holding register already occupied, `save_or_set` enters `S_PUSH` and waits for `stack_ack` (C3-T6 lean A). Queued Branch (RH017): not taken → `resume_addr = queued_save_state + 1` (T16: the word after the Branch, inside the Q region); taken → auto-save (T15).
- **Consequences if the sketch is encoded literally.** (a) The NONEMPTY Branch is *taken* on every empty sweep — the reset state (CR5-R1) — so the second empty sweep enters `S_PUSH`; with `stack_ack` tied 0 the Core would wait forever. (b) A queued Branch on MORE cannot land on PKT(q+1) without a gap: not taken resumes at the Q-region tail, taken auto-saves every packet and stalls from the second.
- **Disposition (proposed).** Phase 3 builds the score around these laws (e.g. discharging the holding register once per sweep, lane polarity, placement) and measures g, T_wake and the per-sweep overhead. If the intended semantics of a queued Branch not taken is "advance past the Stay" rather than "Branch + 1", that is a Core ruling (§3.4b Branch Q row: the relative State Number is computed when the queued target executes).
- **和文.** Core の Branch は taken で自動退避し、保持レジスタが埋まっていれば S_PUSH で `stack_ack` を待つ。キュー帯域 Branch の not-taken は Branch+1（Q 領域内）に再開する。素描をそのまま符号化すると、(a) 空掃引（リセット状態）の2回目で S_PUSH 待ち、(b) MORE による無間隙の前方遷移が成立しない。Phase 3 でこの法に沿った楽譜を設計・実測する。not-taken の再開番地の意図は Core の裁定事項となり得る。
- **Phase 2 addendum (RTL-SIM, `hw/tools/score_rt.py`).** The literal sketch (R1), assembled by `score_as.py` (`hw/l2/scores/d3_sketch_r1_fixture.score`) and run on `ptsg_core_rh031p.v` at P = 1 with `stack_ack` tied 0: **(a)** RT-1, P = 0 — first strobe: NONEMPTY Branch taken → HK (Stay Set → Jump SLEEP = 13 clocks = T_HK) → SLEEP; second strobe: the Branch is taken again, `stack_push_req` rises (clock 302) and the Core stays in S_PUSH at 0x002 to the end of the run. **(b)** RT-3, P = 2, with the SD-14 lane word in front of the NONEMPTY Branch — PKT0 Stay Set → PKT1 Stay Set = **64** clocks = 2 × 32: the queued Branch not taken resumes at Branch + 1, PKT0's own Stay, which runs again as a bare Stay; PKT1 → HK = 32 (MORE false: taken, auto-save). Both as predicted by reading.
- **和文（Phase 2 追記）.** 素描を `score_as.py` で符号化し Core の写しで走らせた（RTL-SIM）。(a) 空掃引の2回目で S_PUSH に留まる。(b) MORE 真の not-taken は自パケットの Stay に戻り、パケット周期が 2N（64）になる。いずれも読解どおり。

### SD-06 — Error strobe into the Core / Core へのエラーストローブ

- **Texts.** Master Ch.5 §5.2 lane 8, §5.8, INT-R2; Register Map v0.3 §8.
- **Found.** `error_flag` is an output; the Core enters `S_HALT` only through its own traps. No external error or halt input exists.
- **Disposition (proposed).** Phase 2 halts the Formation datapath locally, exposes `error_flag`/`error_code`, and drives the Core through the insertion bus or the Condition input as the brief allows — one of the two, documented. INT-R2 remains open.
- **和文.** Core には外部エラー入力がない。Phase 2 で挿入バスか Condition のいずれかを選び、文書化する。INT-R2 は未決のまま。
- **Phase 2 choice.** Insertion. `wpms_formation.v` halts its datapath at the first error (the violator commits nothing), holds `error_flag`, `error_code[4:0]`, `error_sn`, and raises `insert_req` with `insert_target = TRAP_ADDR` (parameter, default 0xFFF) until `insert_ack`. `score_as.py` places a foreground Prog End at the trap address; the Core halts on it (C3-F23 → C3-F24, `S_HALT`, `error_flag`). Inside a Stay window the Core defers an insertion to Stay-timeup (C3-F20), so the Core's own HALT can come up to one Stay later than the Formation's; the Formation's `error_flag` is available at once for L1 silencing (Phase 3/4). Why not Condition: the lane mux already owns `condition` (Deliverable 3 §4), and an error would have to masquerade as a lane value.
- **和文（Phase 2 の選択）.** 挿入バスを採る。Formation は最初のエラーで停止し `insert_req` を `TRAP_ADDR` へ上げ、楽譜はそこに前景 Prog End を置く（C3-F23 → C3-F24 で Core が HALT）。窓の中では挿入は Stay 満了まで延期される（C3-F20）。Condition はレーン多重が使うため採らない。

### SD-07 — Width of I / I の幅

- **Texts.** Register Map v0.3 §1 (W12 class includes K / I / SN / SSS) and §2.
- **Found.** Core `LOOP_W` = 16 since the ruling of 2026-07-07 (RH009); `loop_counter[15:0]`. Master Ch.2 §2.2 gives I the loop-counter width.
- **Disposition (proposed).** Phase 2 zero-extends a 16-bit I. The Map's class to be aligned by ruling.
- **和文.** マップは I を 12 ビット級とするが、Core のループカウンタは 16 ビット。Phase 2 は 16 ビットをゼロ拡張して読む。

### SD-08 — Register W v0.7 editorial / 台帳 W v0.7 の体裁

- **Found.** Lines 80–86 of `PTSG_WPMS_Formation_Decision_Register_W_v0_7.md`: after "None." a headerless table repeats W-R12…W-R17 as open questions; the W-R17 row ("R1 or R2 — the Core's choice, via the architect") predates the ruling in §2.1.
- **Disposition (proposed).** Remove at the next version. The build follows §2.1.
- **和文.** §2.2「なし」の後に v0.6 の未決表の断片が残る。次版で削除。構築は §2.1 に従う。

### SD-09 — Customer mask presets / 顧客のマスク既定値

- **Found.** Appendix 5.B: RETUNE 0x9E3B and RESEED 0x9FFF are described "+ RT.OUT", but RT.OUT is mask bit 16 (§5.4.2, §5.6.2), absent from both values.
- **Disposition (proposed).** Customer correction via the architect. Non-normative; the Phase 5 host script will set bit 16 explicitly.
- **和文.** 付録 5.B の RETUNE/RESEED は「+ RT.OUT」とあるが、値にビット 16 がない。顧客側で訂正を。

### SD-10 — Stale comments in the frozen Core header / 凍結 Core ヘッダの古い注記

- **Found.** Header Tie list (line 46–48 of the frozen file): "C4-T4 Stay Set role … the stay counter ticks only during the wait". Deliberate-simplifications block (lines 51–64): queued band "supports the canonical queued Loop. Other internal-mode commands placed after Prog End execute immediately"; "Instruction memory is modelled with single-cycle (asynchronous) read". All three predate RH011–RH028 and the `ptsg_imem` wrapper; the Core README states the current behaviour.
- **Disposition (proposed).** Comments-only correction at the Core's checkpoint. The working copy `hw/core/ptsg_core_rh031p.v` leaves them as they are, so that its diff against RH030 contains only the brief's items.
- **和文.** 凍結 Core のヘッダに、C4-F10 訂正前・RH014〜RH019 以前・`ptsg_imem` 以前の記述が残る。Core 事務所のチェックポイントでの注記修正を提案。写しでは触れない（差分を指示書の項目に限るため）。

### SD-11 — Registered timing signals and the packet-start clock / 登録型タイミング信号とパケット開始クロック

- **Texts.** Deliverable 2 §2 (`packet_start` = Core Stay Set ∧ TS_PKT, K = 0 on that clock; `bin_valid` = TS_PKT held through the Stay), §3 timing diagram.
- **Found.** `timing_signals` is `output reg`; every word that drives it does so with a non-blocking assignment in its execute clock, so the bits are visible from the next clock (C3-T1 lean A holds the Stay word's bits during the wait). K (`stay_counter`) reads 0 in the Stay Set clock and 1 in the next (RH028 at P = 1).
- **Consequence.** TS_PKT taken straight from the bus rises one clock after the first packet's Stay Set (bin 0, K = 0, would be missed) and falls one clock after the housekeeping Stay Set (one extra clock flagged valid, with K = 0).
- **Disposition (proposed).** Phase 3 derives `packet_start` and `bin_valid` so that the latch clock is the Stay Set clock with K = 0 (or documents a uniform one-clock shift into L1) and proves it against the sweep oracle's bundles.
- **和文.** `timing_signals` は登録出力で、語の D16–D31 は実行の次クロックから見える。TS_PKT をそのまま使うと、パケット列の両端で K と 1 クロックずれる。Phase 3 で K = 0 の Stay Set クロックに揃える導出を決め、オラクルで確かめる。

### SD-12 — Packet floor: 29 nominal, 30 on the Core / パケット下限: 名目 29、Core 上 30 *(Phase 1)*

- **Texts.** Deliverable 3 §6.1 ("With 25 window clocks and 4 Core clocks, N ≥ 29; the profile constant is N_MIN = 32. Oracle-counted; measured in Layer 4"); Register Map v0.3 §9; the header of `wpms_packet.pfasm`; `sweep_sim.py` ("N_MIN = 25 + 4 = 29"), whose Core clocks are declared nominal (brief §2).
- **Found (RTL-SIM, `hw/core/run_phase1.sh`, test SV-5b).** Program Stay Set · 25 BG NOPs · Prog End · queued Jump → Stay Set · Stay, `stay_value` = N, P = 1, on `ptsg_core_rh031p.v`: Stay Set to Stay Set = 30 for N = 29 and 30, and exactly N for N = 31, 32, 33, 64, 2048, 4095; K runs 0 … period − 1 with no error; no idle clock between packets. Cause, by reading: `OP_STAY` times up in its own clock only when `!window_open`; a windowed Stay always enters `S_WAIT`, whose first clock is the earliest timeup. The count is Stay Set (1) + window (25) + Prog End (1) + queued transfer (1) + Stay execute (1) + first S_WAIT clock (1) = 30.
- **Consequence.** None for the constant: N_MIN = 32 ≥ 30. The oracle's "4 control clocks per packet" is one short as a floor; it does not enter the sweep budget, because a packet's time is N whatever its window.
- **Disposition (proposed).** Reports carry 30 (RTL-SIM) beside 29 (ORACLE nominal); Layer 1 unchanged unless ruled. Phase 3 re-measures with the Formation's real window and the chosen score; Phase 6 on silicon.
- **和文.** 25 命令の窓をもつパケット Stay は、この Core では N ≥ 30 で厳密（名目は 25 + 4 = 29）。窓つき Stay は実行クロックでは満了せず必ず S_WAIT に一クロック入るため。定数 N_MIN = 32 は余裕 2 で成立。報告では 30（RTL-SIM）を名目値 29（ORACLE）と並記し、第1層は裁定なしに変えない。

### SD-13 — E8 for SFT / SFT の E8 *(Phase 2)*

- **Texts.** Register W v0.7 §4 (row E8: "arithmetic overflow — MUL/MAC only (W-F30, F 09-27)"), W-F30 ("ADD/SUB wrap modulo 2³²; E8 only for MUL/MAC"), W-R15 ("E8 stays with MUL/MAC"); Register Map v0.3 §3 (1·7 SFT: master semantics), §8 (E8: "MUL/MAC overflow (ADD/SUB wrap and never raise E8)"); master Ch.3 §3.3 E8 ("arithmetic overflow, where the implementation routes it to error … never lost").
- **Found (ORACLE, by reading and by run).** `pfasm_tools_w.py` `Machine.run`: `elif mn == 'SFT': n = int(op, 0); self.accm = sat(self.accm >> n if n >= 0 else self.accm << -n, …)` — a left shift that leaves signed 32 bits raises E8 (and saturates). The model is golden; the hardware (`wpms_formation.v`, `sft_ovf`) raises E8 exactly there, and the cosimulation compares them: of the 75 random sequences that end in E8, 34 end at an SFT (21 MAC, 20 MUL); mutant M17 (no E8 on SFT) is caught.
- **Reading.** W-F30's purpose was to make ADD/SUB modular (phase slots); "only" can be read as "not ADD/SUB" rather than as "not SFT". Under the master's never-lost rule an SFT overflow must go somewhere.
- **Disposition (proposed).** Architect to rule: (a) texts say "MUL/MAC/SFT" at the next version (model and hardware stand), or (b) SFT wraps/saturates silently (model and hardware change together, by ruling). No WPMS program shifts left today (the packet window has no SFT; `exp_maclaurin_w` none).
- **和文.** 台帳 W §4 と Map §8 は E8 を「MUL/MAC のみ」とするが、黄金モデルは SFT の左シフト溢れでも E8 を出す。ハードウェアはモデルに従う（M17 で両者の違いを検出できることも確認）。「のみ」が ADD/SUB を除く意味か、SFT も除く意味かの裁定を求める。

### SD-14 — The lane select of a foreground Branch is one word late / 前景 Branch のレーン選択が一語遅れる *(Phase 2)*

- **Texts.** Deliverable 3 §4 ("The Core has one Condition input. The profile drives it from three lanes, selected by two timing-signal bits of the word being executed (or held)"); §3 sketch (SLEEP `Branch 0` on STROBE, then `Branch +→HK` on NONEMPTY, "[1 clock]").
- **Found (RTL-SIM, `hw/tools/score_rt.py` RT-2).** `timing_signals` is registered (SD-11): a foreground Branch samples `condition` in its execute clock, while the bus still shows the bits of the word executed before it. With the sketch as written, the NONEMPTY Branch at 0x002 is decided on the STROBE lane of SLEEP (the one-clock strobe already low), so it is taken even with P = 2: every sweep goes straight to HK. A queued Branch decided at Stay-timeup is not affected — the held Stay word's bits are current by then (RT-3: MORE decided correctly at both timeups).
- **Disposition (proposed).** Phase 3 picks and documents one: (a) the lane's CSEL rides on the word before the Branch — e.g. `NOP CSEL=NONEMPTY` between SLEEP and the Branch (RT-3 runs exactly this: T_wake becomes 3 clocks, within the D3 §9 bound of 4); (b) the sequencer decodes the lane from `state_number` against the score's addresses. The texts (D3 §4) would then say "selected by the bits on the timing-signal bus", which is what the Core offers. No Core change.
- **和文.** `timing_signals` は登録出力のため、前景 Branch が Condition を見るクロックにはバスに一つ前の語のビットが載っている。素描どおりだと NONEMPTY 判定が SLEEP の STROBE レーンで行われ、P > 0 でも毎回 HK に飛ぶ（RT-2）。キュー帯域の Branch（満了時判定）は影響を受けない。Phase 3 で (a) 直前の語に CSEL を載せる（T_wake 2→3、上限 4 以内）か (b) `state_number` から選ぶかを決めて記す。

### SD-15 — The insertion handshake / 挿入のハンドシェイク *(Phase 3)*

- **Texts.** PTSG-Core Layer 1 Ch.5 §5.9: `insert_req` "1-bit level … External logic should hold `insert_req` asserted until `insert_ack` is received"; `insert_ack` "1-bit pulse … External logic should deassert `insert_req` no earlier than the clock in which it sees `insert_ack`".
- **Found (RTL-SIM, `hw/tools/cosim_sweep.py --directed`, first run).** With the Formation holding `insert_req` in a register until it saw `insert_ack` (so dropping it one clock after the ack, which the text allows), every injected error ended with the Core in S_PUSH at the trap address 0x3FF, `stack_push_req` high, no HALT: the insertion at the packet's timeup set the State Number to 0x3FF and pulsed `insert_ack` (registered, visible the next clock); in that next clock `insert_pending` = S_RUN ∧ `insert_req` ∧ ¬`window_open` was true again, so the Core took the same request a second time before executing the trap word, and the second auto-save spilled.
- **Disposition (proposed).** Formation side, done: `insert_req = insert_req_r ∧ ¬insert_ack` (`wpms_formation.v` RH002); all five injected errors now reach the Core's HALT at 0x3FF (8–61 clocks after the Formation's flag, i.e. within the Stay in progress), and mutant S10 (the fix undone) is caught. Core's office: tighten the text to "deassert in the clock `insert_ack` is high" — which is what the Core's own conformance testbench does (T5a, T23) — or let the RTL ignore `insert_req` while `insert_ack` is high. No Core change here.
- **和文.** Core 第5章 §5.9 は「`insert_ack` を見たクロック以降に `insert_req` を下げよ」と読めるが、RTL は ack の出るクロックにまだ上がっている要求をもう一度受け付け、トラップ番地で保持レジスタを溢れさせて S_PUSH で止まる。Formation 側で ack の間は要求を組合せ的に取り下げる修正を入れた（RH002）。Core 事務所には文言の明確化か RTL 側の無視を提案する。Core は変更しない。
- **Ruling 2026-09-29 and the bug report.** The workaround is approved. A minimal reproduction on the **frozen** source (no Formation: one Core, a program of at most six words, one request) is in `rtl_sim/2026-09-29_sd15_insert_handshake/` (`observation.md`, VCDs) and `hw/core/sd15_insert_handshake_tb.v` / `run_sd15.sh`: a registered drop is accepted twice in all three scenes (S_RUN, bare Stay, window), a drop within the ack clock once, on the frozen source and on the copy alike. By reading, the S_HALT rescue tests the same level. The report — with the two dispositions (text only, or ignore `insert_req` while `insert_ack` is high) — went to the Core's office on 2026-09-29 as [dsohnaka/PTSG-Core#5](https://github.com/dsohnaka/PTSG-Core/issues/5), the PTSG-Core repository's channel for proposals (its CONTRIBUTING: "open an issue first").
- **和文（裁定と報告）.** 回避策は承認。凍結ソース上の最小再現（Formation なし、6 語以内のプログラム）を記録し、Core リポジトリの Issue（同リポジトリの提案窓口）として Core 事務所へ伝える。

### SD-16 — The Maclaurin core / マクローリン・コア *(Phase 4)*

- **Texts.** Customer Ch.2 v1.1: §2.2.4 adopts Approach B (2 clocks per stage, "constant absorption", "+4 bits"); §2.4.1 gives the formats — x′ Q2.25, X Q4.23, every Horner intermediate and every constant C₃…C₁₁ Q1.26; §2.5.1 "Y₁ = (1/362880) − X · (1/39916800), pre-scaled"; §2.8.2 aggregate error ≈ 1.3×10⁻⁷; C2-D10 seven 27×27 multipliers; §2.3.3 "bit-inversion of the 30-bit field, equivalent to two's complement negation modulo 2⁻²". The 2026-04-29 trace describes Approach B as the Ohnaka refactoring `x·(1 − x²/6·(1 − x²/20·(…)))` with (2π)² absorbed. The customer's oracle has no sin function (it fixes exp2, amplitude, phase and the glide bit for bit).
- **Found (ORACLE).** The table read literally cannot meet the budget: C₁₁ = 2⁻²⁶·2 (1.68 rounds to 2: +19 %), C₉ = 185·2⁻²⁶; max |error| over 200,000 phases **3.97×10⁻⁷ = 2⁻²¹·²⁶**. Two's-complement negation maps ξ = 0 of Q2 to ξ′ = 0, i.e. sin(π/2) = 0 (the RTL uses bit inversion; mutant S1 shows the difference is caught). The truncation error at π/2 is (π/2)¹³/13! = 5.69×10⁻⁸, not ≈ 4×10⁻⁸.
- **Realization (Arena, published).** `hw/tools/l1_model.py` `sin_q040` = `hw/l1/wpms_l1_sin.v` bit for bit: u = ξ′ ≫ 4 (26 bits, 2⁻²⁸ cycle); U = u² ≫ 26; S₅ = c₄ − (U·c₅ ≫ 32), S₄ = c₃ − (U·S₅ ≫ 31), S₃ = c₂ − (U·S₄ ≫ 30), S₂ = c₁ − (U·S₃ ≫ 29), S₁ = c₀ − (U·S₂ ≫ 27), sin = u·S₁ ≫ 11 (Q0.40), c_j = (2π)^(2j+1)/(2j+1)! at scales 2²³, 2²⁰, 2¹⁹, 2¹⁹, 2²⁰, 2²² — seven multipliers, all operands ≤ 26 bits, 16 clocks. Max |error| **5.96×10⁻⁸ = 2⁻²⁴·⁰⁰**, exhaustive over u (2²⁶ values, both ends of each u's 16 phases). The Ohnaka refactoring would need a second multiplier per stage for no gain here: the per-stage scales already give every stage 25–26 significant bits.
- **Disposition (proposed).** For the customer, via the architect: state the Horner formats as per-stage scales (or adopt these); correct the reflection wording (bit inversion; two's complement is off by the quadrant boundary); 5.7×10⁻⁸; consider adding a sin model to the oracle so that the whole L1 is golden-checked.
- **Ruling 2026-09-30.** Approved: the realization above is the official specification of the L1's sin, until the customer's next Ch.2 says otherwise. The note for the customer team is `reports/customer_note_sd16_sin.md` (prepared, not sent: the customer's repository is outside this session's scope; the architect conveys it).
- **和文.** 第2章の書式表を字義どおりに組むと C₁₁ が 2 LSB しかなく、誤差は 2⁻²¹·³ で予算の 3 倍。段ごとの 2 冪スケールと 2π の畳み込みで、7 乗算器・16 クロックのまま 2⁻²⁴·⁰（打ち切り誤差そのもの）を得た。l1_model.py に公開。顧客オラクルには sin のモデルがない。反射は「ビット反転」が正しく、「2 の補数と等価」は象限境界でずれる。

### SD-17 — The test origin at NMAX = 1,008 / NMAX 1,008 でのテスト原点 *(Phase 4)*

- **Texts.** Customer Ch.3 §3.10 (N = 2,048, OM0 = 89,120,571, OMD1 = 350, LP = −2,948,988, RT.OUT = 3) and Ch.5 §5.8 (the ROM plays it after reset and on KEY[1]); ruling 2026-09-29: NMAX = 1,008 at 50 MHz.
- **Found (RTL-SIM).** Played as written on the 50 MHz build, the ROM's GO is refused by BCP in the first housekeeping window with EW5 (the new sweep word's Σ N = 2,048 > NMAX), L1 is silent at once, and the Core halts at the trap word 11 clocks later. With N = 1,008 and every other integer as §3.10, the test origin plays bit-exact to the model; its PCM peak over the first 120 samples is 2,002,439 = −12.44 dBFS at G = 12 (N = 2,048 on the 100 MHz budget: 4,068,448 = −6.29 dBFS, the customer's −6.3).
- **Disposition (proposed).** The architect rules the ROM image for the 50 MHz build: (a) N = 1,008 (proposed); (b) N = 2,048 on a 100 MHz build only. Nothing is changed until then; Phase 5 builds the ROM port.
- **Ruling 2026-09-30: (a).** The 50 MHz ROM image carries N = 1,008 with every other integer as §3.10; the 100 MHz image keeps N = 2,048. Phase 5 generates both images (`hw/tools/gen_switch_rom.py`).
- **和文.** テスト原点は N = 2,048。50 MHz（NMAX 1,008）ではスイープ語の Σ N 超過として BCP が EW5 で拒否し、L1 は即無音、Core はトラップで停止する。N = 1,008 なら他の整数はそのままでビット一致で鳴る（G = 12 で −12.44 dBFS）。ROM 像の裁定をお願いしたい。

### SD-18 — The sweep oracle's full-load traffic at NMAX = 1,008 / NMAX 1,008 でのスイープ・オラクルの全負荷 *(Phase 4)*

- **Texts.** `sweep_sim.py` main(): "full-load GO: sigma N = NMAX exactly" — `cuts` over `range(1, NMAX // N_MIN)`, each packet k·N_MIN.
- **Found.** For NMAX = 1,008 (not a multiple of N_MIN = 32) the parts sum to 31·32 = 992: the oracle's traffic never loads a sweep to NMAX at the 50 MHz budget. At NMAX 2,048 (and 1,024 in Phase 3) the property holds.
- **Disposition.** Informative. The worst 50 MHz sweep (8 × 126 = 1,008 bins) is covered by the directed grid case `full8` (RTL-SIM: SWEEP_CLOCKS 1,028 of 1,041). The golden model is not edited.
- **和文.** 1,008 は 32 の倍数でないため、オラクルの「全負荷」GO は Σ N = 992 にとどまる。50 MHz の最悪スイープは指向試験 full8 で確認した。黄金モデルは編集しない。

### SD-19 — The host path: ISSP carries the writes / ホスト経路：書込みを ISSP が運ぶ *(Phase 5)*

- **Texts.** Customer Ch.5 §5.7 (Fixed; C5-D8): writes through a JTAG-reachable memory-mapped master on port 0 — reference the vendor's JTAG-to-Avalon master bridge driven from System Console, a Virtual-JTAG custom protocol as the Arena alternative (§5.11); "ISSP stays required, for probes and a few direct knobs: CLIP, MG, G_EFF, STROBE_INTERVAL, SWEEP_CLOCKS, the inspector. ISSP is no longer the parameter write path; with hundreds of slots, addressable writes are the right tool." The brief (Phase 5): one host path, HPS bridge or UART.
- **Ruling 2026-09-30 (architect).** The Phase 5 host path is Intel's In-System Sources and Probes over JTAG, for sure manual operation in Phase 6: a deterministic controller may exist for white-box verification, with the ISSP bits OR-connected to it; inbox slots, masks, RT.OUT, the sweep word, ARM and GO read and written directly from the Quartus GUI; the simplest, most robust JTAG debug interface.
- **Realization (RTL-SIM).** `hw/switch/wpms_host_bridge.v`: the ISSP instance HOST's 48 source bits are {RD toggle, WR toggle, ADDR[11:0], WDATA[31:0]}; its 36 probe bits {REJ, RD_ACK, WR_ACK, RDATA[31:0]}. A flipped toggle makes one addressable transaction on port 0 of the switch (a write is followed by a read-back), so the whole map of §5.6 is reachable and the chapter's objection ("hundreds of slots") does not arise: the path is addressable. The OR (`wpms_system.v`): the bridge sees `ISSP HOST | host_src_ext`; `host_src_ext` is the port of the testbench's deterministic controller (0 on the board). STAT and INSP keep ISSP's probe role.
- **Disposition (proposed).** For the customer, via the architect: let §5.7 / C5-D8 admit ISSP as a transport of port 0 (or list it with §5.11's alternatives). Nothing of the map, the ports or stage-arm-go changes.
- **Ruling 2026-10-01 (architect).** The addressable ISSP transactions are **formally adopted** as the profile's host path. The customer may be told that the profile overrides C5-D8 for its host path. The note for the customer team is `reports/customer_note_sd19_host_path.md` (prepared, not sent: the customer's repository is outside this session's scope; the architect conveys it).
- **和文.** 第 5 章 §5.7 は書込み経路を JTAG-to-Avalon マスターとし「ISSP はもはやパラメータ書込み経路ではない」とするが、2026-09-30 の裁定で Phase 5 のホスト経路は ISSP となった。ISSP の HOST インスタンスが §5.6 のアドレス付きトランザクション（ADDR・WDATA・書込み／読出しトグル）を運ぶ形で実現したので、マップもポートも置く・構える・放つも変わらない。第 5 章の文言の扱いは顧客へ。

### SD-20 — The ROM's list against ownership / ROM の書込み列と所有 *(Phase 5)*

- **Texts.** Ch.5 §5.8: the ROM (port 3) "holds a short list of (address, data) writes ending in GO_ALL"; its initial content writes module 0 block 0 with the full mask, the SWEEP words, MG_TARGET = 0 and "all owners = port 0". §5.5.2: "A write, arm or GO from a non-owner is rejected and counted in REJECT[port] … GO_ALL (port 0 or 3 only) fires every armed item. Changing an owner disarms that item."
- **Found (reading).** If owners start at port 0, the ROM's writes to block 0 are refused; if the ROM sets "all owners = port 0" before its GO_ALL (the list ends in GO_ALL), it disarms its own items. The list works only if port 3 is exempt from ownership for its own writes, which the text does not say.
- **Realization.** The minimal switch builds ports 0 and 3 — the two privileged ports. OWNER[m] is stored and read back; ownership is not enforced and a change of owner disarms nothing (with ports 0 and 3 only, no transaction would be refused by it). Enforcement belongs with port 1 or 2.
- **Disposition (proposed).** Customer to state the ROM's standing: port 3 exempt from ownership for its own list (proposed), or owners written first with no disarm of the ROM's own items.
- **Ruling 2026-10-01 (architect).** Approved: the ROM (port 3) is exempt from the ownership rules. With ports 0 and 3 only, nothing changes in the switch (OWNER is stored, not enforced). When port 1 or 2 is built with enforcement, port 3's writes, arms and GO_ALL are not subject to it, and a change of owner does not disarm the ROM's own items.
- **和文.** ROM（ポート 3）の書込み列は、ブロック 0 の書込み・「全所有者 = ポート 0」・最後に GO_ALL を含むが、§5.5.2 の所有規則（非所有者の書込み拒否、所有者変更で disarm）と字義どおりには両立しない。最小スイッチは特権ポート 0・3 のみなので OWNER は保持・読出しのみで施行しない。ROM の扱いの明記を顧客へ提案。

### SD-21 — "Armed" means two things / 「構え」の二義 *(Phase 5)*

- **Texts.** Ch.5 §5.4.2: stage, **arm** (COMMIT with the arm bit), go (GO), acknowledge; §5.4.3: "A GO is latched and handed to all Formations on the next synchronized strobe … GO → first sweep playing it: ≤ 2 sample periods". Map v0.3 §7: "At each synchronized strobe the sequencer latches the take-set: the blocks and sweep item **armed** at that moment."
- **Found.** Read with Ch.5's meaning, Map v0.3 §7 would take items armed but not yet fired. The profile's "armed" must mean *handed over by a GO*. Realized that way: the switch keeps the writer's arm and hands over the fired set; the Formation's flags are written in one clock (RH004: inbox port 0x9F), so a strobe takes all of a GO or none. The Phase 5 timing case (hand-overs presented from 3 clocks before to 3 clocks after a strobe) then found that a registered hand-over presented in the strobe clock itself missed that strobe: a GO accepted in the clock before a strobe played from the third strobe (2 periods + 1 clock). RH004 therefore also lets the take-set include an arm write presented in the strobe's own clock: every GO now plays from the second strobe after its acceptance (RTL-SIM: 960 GOs over fifteen runs; the timing case puts hand-overs at every offset from −3 to +3 clocks around a strobe, 62 at each budget, all heard).
- **Disposition (proposed).** Map v0.3 §7 at its next version: "the items handed over (fired) at that moment, a hand-over in the strobe's own clock included".
- **Ruling 2026-10-01 (architect).** RH004 is approved, and the definition of "armed" in Map §7 may change at the Map's next version. Not applied here: `01_Architecture/` is the law and is not edited in this phase; the wording above waits for the Map's next version.
- **和文.** 第 5 章の「構え」は GO 前の段階、Map v0.3 §7 の「構えられた項目」は GO で引き渡された項目の意味でなければならない。スイッチは構えを保持し、発火した集合を 1 クロックで Formation に渡す（RH004）。さらにタイミング試験で、ストローブ直前に受理された GO が 3 番目のストローブまで遅れる（2 周期 + 1 クロック）ことを見つけ、ストローブのクロックに提示された書込みも取込みに含めるようにした。いまはすべての GO が受理後 2 番目のストローブから鳴る。

### SD-22 — clk_sys does not close at 50 MHz / clk_sys が 50 MHz で収束しない *(Phase 6)*

- **Texts.**
  - Brief Phase 6: the board at 100 MHz, with timing closure.
  - Ruling 2026-09-28: "schedule first — if 100 MHz is at all difficult the target becomes 50 MHz …; no pipelining of the long paths now; timing optimization after correct operation". Ruling 2026-09-29: NMAX = 1,008 at 50 MHz.
  - Phase 2's clock table (`phase2_datapath.md` §3): the Formation registers each issue (stage I) and executes it in the next clock (stage X), one per clock, never stalled (IF-1). The read, the computation, the error check and the commit — the store write included — all happen in X.
  - Phase 2 §6 Q4 had named three paths as long for one clock at 100 MHz: MUL @PPM, BCP's EW5, and the commit fan-out.
- **Found (STA).** Quartus Prime Lite 23.1std.1, revision `DE10_Nano_wpms` (50 MHz), 5CSEBA6U23I7, the slow corner (1100 mV, 85 °C).
  - clk_sys setup slack is **−14.307 ns** against the 20 ns period, so the worst path takes about 34 ns. TNS is −65,525.293 ns; hold is met (+0.033 ns).
  - Every other clock meets: FPGA_CLK1_50 +12.962 ns, hdmi_tx_clk +2.975 setup / +2.968 hold, the pixel clock +6.516, MCLK +74.428, JTAG +3.395.
- **Diagnosis (by reading, and by gate depth).** The summary names no path. The depths come from Yosys 0.69: gates before LUT mapping, a multiplier counted as one cell.
  - **The Formation, depth 146.** The chain is `adrs → region → a_block → pmask / forwarded store read → rd_val → src → m_b → 32 × 32 product → >>> SHV → + src → overflow → x_err → x_commit → dp_st_we → cp_go → pending masks → pm_idle_next → inbox_taken / taken_due`.
  - **The tail of that chain is structural only.** One `x_commit`, computed for every instruction, drives:
    - the store's write enables: ≈ 4,100 flip-flops, plus the M10K copies of the nine banks the prefetch reads;
    - the background copy;
    - the pending masks.

    But the store is written only by STM and STA @PPM, and their errors (E4, E5, EW3, EW4) do not depend on the multiplier. BCP's errors (E4, EW4, EW5) do not either. So the multiplier's overflow can never decide those enables, yet in the netlist they wait for it. If about 4,000–5,000 endpoints fail near −13 ns, that gives this TNS — the store failing together. That is an inference; the grouped report will confirm or correct it.
  - **The long paths that are real:**
    - **MUL @PPM:** address decode → forwarded store read → multiply → shift → overflow → commit → Accm;
    - **BCP:** pending masks → N select → the sum of eight N, written as a chain → EW5 → commit → pending masks → inbox_taken;
    - **the switch's GO check (depth 99):** transaction decode → the items GO fires → the sum of N over the sweep word, a chain → go_bad → reject or hand-over.
  - The other modules are short: L1 42, the output stage 52, the sequencer 12.
- **Not proposed.**
  - A multicycle exception: each of these paths is single-cycle by the clock table, so an exception would hide a real failure.
  - A slower clk_sys: NMAX 1,008 needs 50 MHz.
  - Fewer instructions per clock: IF-1 forbids it.
- **Disposition (proposed).** Both steps are RTL changes. After each step: the Phases 2–6 recipes, which must keep the window floor at 30, BCP at 10, T_wake at 2, and every bundle and bank bit-exact; then a new fit.
  1. **Restructuring, with behaviour unchanged.** No clock is added; the recorded runs must repeat cycle for cycle.
     - (a) Each register's enable comes from its own instructions' error conditions, not from the one `x_commit`. The store, the copy and the pending masks no longer wait for the multiplier.
     - (b) The address decode (region, block, slot) is registered with ADRS.
     - (c) The sums of N become balanced adder trees, in the Formation (EW5) and the switch (the GO check).

     These would be Formation RH005 and switch RH002. Expected (estimate): the store leaves the critical path. MUL @PPM remains, at roughly 20–22 ns on this speed grade, so possibly still short.
  2. **A write-back clock, only if step 1 does not close.**
     - Accm, Temp and the store are written one clock after X.
     - E8 is checked there; on an error, the next instruction is squashed.
     - Accm and the store are forwarded to the next instruction and to the prefetch.
     - BCP and the background copy keep their clocks, so BCP ≤ 10 holds.

     The program sees nothing of this, but the Phase 2 clock table changes: the store lands one clock later, and E8 is raised one clock later. Expected (estimate): MUL @PPM at roughly 16–18 ns. This is a pipeline, so the 2026-09-28 ruling must be lifted for it.

  The failing-path report comes first: `hw/de10_nano/report_setup_paths.tcl` (RH002) groups every failing endpoint, and gives the worst path into each register class.
- **Ruling 2026-10-03 (architect).** Step 1 now. If step 1 does not close, step 2 follows without asking again; for step 2 the 2026-09-28 ruling's "no pipelining of the long paths now" is lifted.
- **Step 1 realized (2026-10-03).**
  - What changed: Formation RH005 and switch RH002, exactly the three items above. The repeat checks (EW5's, and the switch's PR-1) are also made pairwise, beside the sums they share a check with.
  - Evidence that nothing changed:
    - RTL-SIM: each module ran beside its previous revision on random stimulus for 400,000 clocks per run, in 8 runs, comparing every output and every register in every clock — 0 differences. Phases 2–6 repeated the record: the 18 board runs and the 16 expected captures are identical, the captures byte for byte. The 20 mutants were caught at the same counts; 3 new mutants of the new structure are caught.
    - Formal (SAT): every restructured function is proved equal to the one it replaces.
  - ESTIMATE (gate depth): the store's chain went from 136 levels to 33, the pending masks and inbox_taken from 136–146 to 56–66. The longest is now the real MUL/MAC @PPM path into the error registers (112) and Accm (106). Was 146.
  - Next: the second fit decides (`rtl_sim/2026-10-03_sd22_step1/`, `phase6_silicon.md` §10).
- **The second fit (2026-10-03, after step 1).** clk_sys −6.976 ns, TNS −1,509 ns (the first fit: −14.307, −65,525). `report_setup_paths.tcl`: 799 failing endpoints in four groups. These are the switch's GO check (−2.6 ns), MUL/MAC @PPM (−6.8), BCP's EW5 (−4.8), and the Core's imem half-cycle path (−2.0, SD-23). Details: `quartus/2026-10-03_DE10_Nano_wpms_fit2/observation.md`.
- **Step 2 realized (2026-10-03), as ruled, without a new round.**
  - **Formation RH006.**
    - The E8 of MUL and MAC is decided in the clock after X. Accm is written in X and restored if the product did not fit; the instruction then in X is squashed.
    - A prefetch's EW2 met in a MUL's or MAC's X clock waits one clock, so that the MUL's E8 keeps its priority: every error keeps its code and SN.
    - The operand is read one clock ahead, with the instruction in X taken to complete. If it does not complete, the Formation halts at that edge and the value is never read.
    - EW5's sum of N is reduced one clock ahead by carry-save adders.
  - **Switch RH003.** The GO check takes its items from the request's fields, without the address decode and the frozen bits; its sum of N uses carry-save adders and one sign.
  - **What changed on purpose:** those two errors are raised one clock later, with the same code and SN. In those two cases the trap request and L1's silence come one clock later, and the Core may issue one more instruction, which the Formation drops. Nothing else changed.
  - **Evidence:**
    - RTL-SIM: lockstep against the previous revisions, 0 differences in 8 runs of 400,000 clocks; every late error came with the reference's code and SN.
    - Formal: 13/13 proofs (SAT).
    - Phase 2: 3,923/3,923 cases, 29/29 mutants.
    - Phases 3–6: all checks passed; the 18 board runs and the 34 expected files are identical to the record (`rtl_sim/2026-10-03_sd22_step2/`, `phase6_silicon.md` §11).
  - **Next:** the third fit decides, with clk_sys at 30 % high for the Core's half-cycle path (SD-23).
- **The third fit (2026-10-04, after PR #7).** clk_sys **closes: setup +0.978 ns, TNS 0** (the Slow 1100 mV 0 °C model), hold +0.042 ns; every clock meets.
  - The 10 worst endpoints are all `w_hi`, MAC's product kept for the late E8, at 18.8 ns of data delay. Of that, 3.5 ns is the opcode decode in front of the operand select; the estimate (about 15 ns) had left it out.
  - The other groups of the second fit are not among the 10 worst (slack ≥ +1.547 ns).
  - Resources (Fitter): 11,321.7 ALMs; the Formation 7,048.0 (+259 over the first fit).
  - Details: `quartus/2026-10-04_DE10_Nano_wpms_fit3/observation.md`.
  - **SD-22 is resolved for the 50 MHz revision.** 100 MHz follows once 50 MHz operation is established (the architect, 2026-10-04).
- **100 MHz.** Not expected to close even after step 2. Accm's recurrence (multiply, shift, add, one instruction per clock) alone exceeds 10 ns on this device (estimate). 50 MHz stays the target (ruling 2026-09-28).
- **和文.**
  - 初回フィット（50 MHz 版）で clk_sys のセットアップスラックが −14.307 ns となった。周期 20 ns に対し、最悪経路は約 34 ns。TNS は −65,525 ns。ほかのクロックはすべて満たす。
  - 原因：Formation の X クロックに、次の処理が直列に並ぶ（ゲート深さ 146）。
    - アドレス解読、転送付きストア読出し
    - 32×32 乗算、シフト、加算、桁あふれ検査
    - エラー優先、コミット
    - ストア書込み許可（約 4,100 FF）、背景コピーの保留論理
  - このうち乗算器からストア・コピー・保留マスクへ至る部分は、構造上だけ存在する。ストアを書く STM・STA @PPM のエラーも、BCP のエラーも、乗算に依存しないため。
  - 実在する長経路は MUL @PPM、BCP の EW5（N の 8 項和の連鎖）、スイッチの GO 検査（深さ 99）。
  - 提案は 2 段階。
    1. 動作を変えない再構成。各レジスタの許可をその命令自身のエラー条件から作り、アドレス解読をレジスタ化し、N の和を加算木にする。
    2. それで足りなければ書戻しクロックを加える。これはパイプライン化なので、2026-09-28 の裁定の解除が必要。
  - マルチサイクル例外とクロック低下は提案しない。まず失敗経路の集計（`report_setup_paths.tcl`）を受け取りたい。100 MHz は 2 の後でも収束しない見込み。
  - **第 3 回フィット（2026-10-04）：clk_sys は +0.978 ns、TNS 0 で収束した。** 50 MHz 版について SD-22 は解決。最悪経路は MAC → `w_hi`（18.8 ns）。100 MHz は 50 MHz の動作確立後（アーキテクト）。

### SD-23 — The Core's imem half-cycle path at 50 MHz / Core の imem 半周期経路（50 MHz） *(Phase 6)*

- **Texts.**
  - `PTSG-Core/03_Sample_Implementations/ai_friendly_vendor_wrappers/ptsg_imem/ptsg_imem.v` (frozen, as the Core): with `EDGE = "NEG"` the address is captured at the falling edge and the word must be valid before the next rising edge; "At 50 MHz (10 ns half-period) this is comfortable on Cyclone V (M10K Tco ~2.4 ns); practical ceiling is roughly 80-120 MHz."
  - The Core's DE10-nano README ("Known state"): "Non-binding at 50 MHz"; and for 100 MHz: "no multicycle waiver is legitimate … the remedies are RTL-side (the EDGE="POS" + fetch-stage migration …) or a faster speed grade — not SDC relaxation". `DE10_Nano_golden_top.sdc` says the same.
- **Found (STA, the second fit, slow 1100 mV 85 °C).**
  - 113 Core endpoints fail: `state_num` −2.028 ns, `loop_cnt` −2.018, `stay_cnt` −1.164, `queued_target` −1.090, `hr_state` −0.508, `hr_base` −0.172, the FSM's state bits down to −0.006 (`setup_clk_sys_groups.txt`).
  - The worst path (`setup_clk_sys_keys.rpt`): the M10K, clocked by the inverted clk_sys, gives its word 1.06 ns after its clock; then 10 LUT levels of the Core's next-state logic, `Decoder0 → WideOr7` (four levels) `→ state_num[11]~23…~26 → state_num~43 → state_num[0]`, 10.703 ns of data delay against the 10 ns half period. Clock skew −1.245 ns: the M10K's own clock delay (1.518 ns) lies on the launch side.
  - The cells are already placed close together (X18–X27, Y12–Y13 beside the M10K at X26 Y12). 2 ns is about a fifth of the path; Fitter settings will not recover it.
  - The Core here is the RH031p copy (Phase 1); this path is its decode of the fetched word, not something WPMS added.
- **Options.**
  - (a) **clk_sys's duty cycle** (board level; Core and wrapper untouched). The only user of clk_sys's falling edge is the imem. A falling edge earlier in the period lengthens the read side (falling → rising) and shortens the address side (rising → falling). The address side is `state_num`, a register, straight into the M10K's address register, so it is short; and the M10K's clock delay is in its favour there. STA analyzes the real waveform: nothing is relaxed or waived.
  - (b) The Core's documented migration, EDGE "POS" + a fetch stage: changes the Core's one-clock-per-opcode model (Layer 1, C2-T4). Not mine to do.
  - (c) A faster speed grade: not on this board. (d) A slower clk_sys: NMAX 1,008 needs 50 MHz.
- **Applied for the third fit (reversible).** (a), with 30 % high: the falling edge 6 ns after the rising one; the read side gets 14 ns (+4 ns; −2.03 → about +2 ns if the path stays as placed), the address side 6 ns. `SYS_DUTY` is a parameter of the board top, given to the clk_sys PLL as `duty_cycle0` (wpms_pll RH002, top RH002); `make_quartus_project.py` (RH003) sets it per revision (`set_parameter -name SYS_DUTY 30` in `DE10_Nano_wpms.qsf`; the 100 MHz revision stays at 50) and checks it in the elaborated PLL. `--sys-duty 50` builds the 50 MHz revision exactly as the first two fits had it. The RTL simulations are unaffected: the board bench's clock stays symmetric, and in zero-delay RTL the position of the falling edge changes nothing. The PLL makes the duty cycle with its output counter, in steps of half a VCO period: at a 1,000 MHz VCO, 6 periods high out of 20 give 30 % exactly. The Fitter's PLL report shows the duty cycle it set, and `derive_pll_clocks` analyzes that waveform. On the second fit's figures the read side needs about 12.0 ns, so any time high up to about 39 % keeps it positive.
- **Ruling requested.** Keep (a), or prefer (b) (or another remedy). Until a ruling, the third fit uses (a).
- **The third fit (2026-10-04).** (a) works.
  - clk_sys's minimum pulse width slack fell by 4.0 ns (8.541 → 4.544): the Fitter set 30 % exactly.
  - None of the Core's paths is among the 10 worst (slack ≥ +1.547 ns, against −2.028 ns in the second fit), and hold is met.
- **Ruling 2026-10-04 (architect).** (a) is adopted: clk_sys runs 30 % high in the 50 MHz revision.
- **和文.**
  - 第 2 回フィットで、Core の 113 端点が失敗した（最悪 −2.028 ns、`state_num`）。
    - imem（`ptsg_imem`、EDGE "NEG"）の M10K を立下りで読み、次の立上りまでに Core の次状態論理（10 段）を通す半周期経路である。
    - データ遅延は 10.70 ns で、半周期 10 ns を超える。
  - Core 側の文書は「50 MHz では余裕がある」としているが、本設計では足りなかった。
  - Core とラッパーには触れない。第 3 回フィットでは、ボード側の PLL で clk_sys のデューティ比を 30 % にする。
    - 立下りを立上りの 6 ns 後にすることで、読出し側が 14 ns、アドレス側が 6 ns になる。
    - タイミング解析は実際の波形で行われ、例外指定はない。
    - `--sys-duty 50` で元に戻せる。
    - デューティ比は PLL の出力カウンタで作る（VCO 1,000 MHz なら 20 周期中 6 周期で、ちょうど 30 %）。実際の値は Fitter の PLL 報告に出る。読出し側は約 12.0 ns 要るので、ハイ期間が約 39 % までなら正のスラックが残る。
  - Core の文書にある移行策（EDGE "POS"＋フェッチ段、第 1 層の事項）との選択について、裁定をお願いしたい。
  - 第 3 回フィット（2026-10-04）で (a) の効果を確認した。デューティ比は 30 % が設定どおり入り、Core の経路は最悪 10 本に入らない（スラック +1.547 ns 以上、第 2 回は −2.028 ns）。2026-10-04 の裁定で (a) を正式採用した。
