dsohnaka/PTSG-WPMS-Formation/(list of files, cad)

Other CAD files:
03_Sample_Implementations/hw/de10_nano/wpms_tap.stp
