dsohnaka/PTSG-WPMS-Formation/04_Verification_Evidence/quartus/2026-10-03_DE10_Nano_wpms_fit2/setup_clk_sys_groups.txt

# clk_sys setup, slow model, revision DE10_Nano_wpms: 799 failing endpoints, TNS -1398.338 ns
# by endpoint register (bit and word indices folded to []), the most negative TNS first
# endpoints   worst_ns       tns_ns  levels  delay_ns  endpoint group  <-  start of its worst path
        136     -2.453     -217.232      15    21.916  wpms_system:u_sys|wpms_switch:u_sw|cmask_v[]  <-  wpms_system:u_sys|wpms_switch:u_sw|fired[]
         32     -6.805     -207.093      17    26.179  wpms_system:u_sys|wpms_synth_top:u_synth|wpms_l2_top:u_l2|wpms_formation:form|accm[]  <-  wpms_system:u_sys|wpms_synth_top:u_synth|wpms_l2_top:u_l2|wpms_formation:form|pmask[][]
         96     -2.605     -176.873      16    21.934  wpms_system:u_sys|wpms_switch:u_sw|n_fu_v[]  <-  wpms_system:u_sys|wpms_switch:u_sw|x_a[]
         92     -3.246      -88.643      13    22.660  wpms_system:u_sys|wpms_synth_top:u_synth|wpms_l2_top:u_l2|wpms_formation:form|pmask[][]  <-  wpms_system:u_sys|wpms_switch:u_sw|ft[]
         32     -2.425      -72.836      16    21.893  wpms_system:u_sys|wpms_switch:u_sw|reject0[]  <-  wpms_system:u_sys|wpms_switch:u_sw|fired[]
         32     -2.277      -66.544      16    21.759  wpms_system:u_sys|wpms_switch:u_sw|reject3[]  <-  wpms_system:u_sys|wpms_switch:u_sw|fired[]
         10     -6.782      -62.449      17    26.151  wpms_system:u_sys|wpms_synth_top:u_synth|wpms_l2_top:u_l2|wpms_formation:form|accm[]~DUPLICATE  <-  wpms_system:u_sys|wpms_synth_top:u_synth|wpms_l2_top:u_l2|wpms_formation:form|pmask[][]
         32     -1.904      -60.767      15    21.383  wpms_system:u_sys|wpms_switch:u_sw|go_seq[]  <-  wpms_system:u_sys|wpms_switch:u_sw|fired[]
         28     -2.076      -52.761      15    21.607  wpms_system:u_sys|wpms_switch:u_sw|sw_fu[]  <-  wpms_system:u_sys|wpms_switch:u_sw|fired[]
         35     -2.922      -34.024      13    22.342  wpms_system:u_sys|wpms_synth_top:u_synth|wpms_l2_top:u_l2|wpms_formation:form|pmask[][]~DUPLICATE  <-  wpms_system:u_sys|wpms_switch:u_sw|ft[]
         32     -2.055      -34.002      17    21.375  wpms_system:u_sys|wpms_switch:u_sw|ibx_wdata[]  <-  wpms_system:u_sys|wpms_switch:u_sw|x_a[]
         28     -1.753      -32.494      13    21.188  wpms_system:u_sys|wpms_synth_top:u_synth|wpms_l2_top:u_l2|wpms_formation:form|sweep_a[]  <-  wpms_system:u_sys|wpms_synth_top:u_synth|wpms_l2_top:u_l2|wpms_formation:form|copied[]
          5     -6.319      -30.888      17    25.708  wpms_system:u_sys|wpms_synth_top:u_synth|wpms_l2_top:u_l2|wpms_formation:form|error_code[]  <-  wpms_system:u_sys|wpms_synth_top:u_synth|wpms_l2_top:u_l2|wpms_formation:form|pmask[][]
         16     -2.018      -27.556      13    10.719  wpms_system:u_sys|wpms_synth_top:u_synth|wpms_l2_top:u_l2|ptsg_core:core|loop_cnt[]  <-  wpms_system:u_sys|wpms_synth_top:u_synth|wpms_l2_top:u_l2|ptsg_core:core|ptsg_imem:ptsg_imem|altsyncram:g_m10k.u_rom|altsyncram_1uc1:auto_generated|altsyncram_fee2:altsyncram1|ram_block3a*~porta_we_reg
         10     -2.416      -22.825      16    21.888  wpms_system:u_sys|wpms_switch:u_sw|reject0[]~DUPLICATE  <-  wpms_system:u_sys|wpms_switch:u_sw|fired[]
         11     -2.142      -22.772      16    21.617  wpms_system:u_sys|wpms_switch:u_sw|reject3[]~DUPLICATE  <-  wpms_system:u_sys|wpms_switch:u_sw|fired[]
         12     -2.028      -20.696      10    10.703  wpms_system:u_sys|wpms_synth_top:u_synth|wpms_l2_top:u_l2|ptsg_core:core|state_num[]  <-  wpms_system:u_sys|wpms_synth_top:u_synth|wpms_l2_top:u_l2|ptsg_core:core|ptsg_imem:ptsg_imem|altsyncram:g_m10k.u_rom|altsyncram_1uc1:auto_generated|altsyncram_fee2:altsyncram1|ram_block3a*~porta_we_reg
          9     -1.904      -17.089      15    21.377  wpms_system:u_sys|wpms_switch:u_sw|go_seq[]~DUPLICATE  <-  wpms_system:u_sys|wpms_switch:u_sw|fired[]
         16     -1.090      -16.068       9     9.788  wpms_system:u_sys|wpms_synth_top:u_synth|wpms_l2_top:u_l2|ptsg_core:core|queued_target[]  <-  wpms_system:u_sys|wpms_synth_top:u_synth|wpms_l2_top:u_l2|ptsg_core:core|ptsg_imem:ptsg_imem|altsyncram:g_m10k.u_rom|altsyncram_1uc1:auto_generated|altsyncram_fee2:altsyncram1|ram_block3a*~porta_we_reg
         12     -1.164      -13.848      11     9.840  wpms_system:u_sys|wpms_synth_top:u_synth|wpms_l2_top:u_l2|ptsg_core:core|stay_cnt[]  <-  wpms_system:u_sys|wpms_synth_top:u_synth|wpms_l2_top:u_l2|ptsg_core:core|ptsg_imem:ptsg_imem|altsyncram:g_m10k.u_rom|altsyncram_1uc1:auto_generated|altsyncram_fee2:altsyncram1|ram_block3a*~porta_we_reg
          8     -1.539      -11.540      16    20.870  wpms_system:u_sys|wpms_switch:u_sw|nv_fu[]  <-  wpms_system:u_sys|wpms_switch:u_sw|x_a[]
         11     -1.752      -11.312      13    21.180  wpms_system:u_sys|wpms_synth_top:u_synth|wpms_l2_top:u_l2|wpms_formation:form|sweep_a[]~DUPLICATE  <-  wpms_system:u_sys|wpms_synth_top:u_synth|wpms_l2_top:u_l2|wpms_formation:form|copied[]
          9     -1.312      -10.230      17    20.634  wpms_system:u_sys|wpms_switch:u_sw|arm[]  <-  wpms_system:u_sys|wpms_switch:u_sw|x_a[]
          9     -1.341      -10.008      16    20.640  wpms_system:u_sys|wpms_switch:u_sw|fired[]  <-  wpms_system:u_sys|wpms_switch:u_sw|x_a[]
          7     -2.059       -8.602      17    21.395  wpms_system:u_sys|wpms_switch:u_sw|ibx_addr[]  <-  wpms_system:u_sys|wpms_switch:u_sw|x_a[]
          7     -1.302       -7.621      17    20.622  wpms_system:u_sys|wpms_switch:u_sw|arm[]~DUPLICATE  <-  wpms_system:u_sys|wpms_switch:u_sw|x_a[]
          1     -6.631       -6.631      17    26.082  wpms_system:u_sys|wpms_synth_top:u_synth|wpms_l2_top:u_l2|wpms_formation:form|error_flag  <-  wpms_system:u_sys|wpms_synth_top:u_synth|wpms_l2_top:u_l2|wpms_formation:form|a_block[]
          5     -1.336       -6.011      16    20.637  wpms_system:u_sys|wpms_switch:u_sw|fired[]~DUPLICATE  <-  wpms_system:u_sys|wpms_switch:u_sw|x_a[]
          5     -1.164       -5.814      11     9.838  wpms_system:u_sys|wpms_synth_top:u_synth|wpms_l2_top:u_l2|ptsg_core:core|stay_cnt[]~DUPLICATE  <-  wpms_system:u_sys|wpms_synth_top:u_synth|wpms_l2_top:u_l2|ptsg_core:core|ptsg_imem:ptsg_imem|altsyncram:g_m10k.u_rom|altsyncram_1uc1:auto_generated|altsyncram_fee2:altsyncram1|ram_block3a*~porta_we_reg
         12     -0.508       -5.752      11     9.230  wpms_system:u_sys|wpms_synth_top:u_synth|wpms_l2_top:u_l2|ptsg_core:core|hr_state[]  <-  wpms_system:u_sys|wpms_synth_top:u_synth|wpms_l2_top:u_l2|ptsg_core:core|ptsg_imem:ptsg_imem|altsyncram:g_m10k.u_rom|altsyncram_1uc1:auto_generated|altsyncram_fee2:altsyncram1|ram_block3a*~porta_we_reg
          1     -5.343       -5.343      17    24.749  wpms_system:u_sys|wpms_synth_top:u_synth|wpms_l2_top:u_l2|wpms_formation:form|insert_req_r  <-  wpms_system:u_sys|wpms_synth_top:u_synth|wpms_l2_top:u_l2|wpms_formation:form|pmask[][]
          1     -4.812       -4.812      16    24.243  wpms_system:u_sys|wpms_synth_top:u_synth|wpms_l2_top:u_l2|wpms_formation:form|taken_due  <-  wpms_system:u_sys|wpms_switch:u_sw|ft[]
          1     -4.756       -4.756      16    24.183  wpms_system:u_sys|wpms_synth_top:u_synth|wpms_l2_top:u_l2|wpms_formation:form|inbox_taken  <-  wpms_system:u_sys|wpms_switch:u_sw|ft[]
          2     -1.739       -3.118      15    21.269  wpms_system:u_sys|wpms_switch:u_sw|cmask_v[]~DUPLICATE  <-  wpms_system:u_sys|wpms_switch:u_sw|fired[]
         12     -0.172       -2.064      11     8.851  wpms_system:u_sys|wpms_synth_top:u_synth|wpms_l2_top:u_l2|ptsg_core:core|hr_base[]  <-  wpms_system:u_sys|wpms_synth_top:u_synth|wpms_l2_top:u_l2|ptsg_core:core|ptsg_imem:ptsg_imem|altsyncram:g_m10k.u_rom|altsyncram_1uc1:auto_generated|altsyncram_fee2:altsyncram1|ram_block3a*~porta_we_reg
          2     -1.048       -1.866       9     9.742  wpms_system:u_sys|wpms_synth_top:u_synth|wpms_l2_top:u_l2|ptsg_core:core|queued_target[]~DUPLICATE  <-  wpms_system:u_sys|wpms_synth_top:u_synth|wpms_l2_top:u_l2|ptsg_core:core|ptsg_imem:ptsg_imem|altsyncram:g_m10k.u_rom|altsyncram_1uc1:auto_generated|altsyncram_fee2:altsyncram1|ram_block3a*~porta_we_reg
          1     -1.714       -1.714      13    10.394  wpms_system:u_sys|wpms_synth_top:u_synth|wpms_l2_top:u_l2|ptsg_core:core|loop_cnt[]~DUPLICATE  <-  wpms_system:u_sys|wpms_synth_top:u_synth|wpms_l2_top:u_l2|ptsg_core:core|ptsg_imem:ptsg_imem|altsyncram:g_m10k.u_rom|altsyncram_1uc1:auto_generated|altsyncram_fee2:altsyncram1|ram_block3a*~porta_we_reg
          1     -1.697       -1.697      12    10.389  wpms_system:u_sys|wpms_synth_top:u_synth|wpms_l2_top:u_l2|ptsg_core:core|state_num[]~DUPLICATE  <-  wpms_system:u_sys|wpms_synth_top:u_synth|wpms_l2_top:u_l2|ptsg_core:core|ptsg_imem:ptsg_imem|altsyncram:g_m10k.u_rom|altsyncram_1uc1:auto_generated|altsyncram_fee2:altsyncram1|ram_block3a*~porta_we_reg
          1     -1.679       -1.679      16    21.020  wpms_system:u_sys|wpms_switch:u_sw|ibx_addr[]~DUPLICATE  <-  wpms_system:u_sys|wpms_switch:u_sw|x_a[]
          1     -1.265       -1.265      13     9.988  wpms_system:u_sys|wpms_synth_top:u_synth|wpms_l2_top:u_l2|ptsg_core:core|fsm.S_IND  <-  wpms_system:u_sys|wpms_synth_top:u_synth|wpms_l2_top:u_l2|ptsg_core:core|ptsg_imem:ptsg_imem|altsyncram:g_m10k.u_rom|altsyncram_1uc1:auto_generated|altsyncram_fee2:altsyncram1|ram_block3a*~porta_we_reg
          1     -1.164       -1.164      16    20.506  wpms_system:u_sys|wpms_switch:u_sw|ibx_hand  <-  wpms_system:u_sys|wpms_switch:u_sw|x_a[]
          1     -1.139       -1.139      17    20.461  wpms_system:u_sys|wpms_switch:u_sw|d_rej  <-  wpms_system:u_sys|wpms_switch:u_sw|x_a[]
          1     -1.007       -1.007      11     9.704  wpms_system:u_sys|wpms_synth_top:u_synth|wpms_l2_top:u_l2|ptsg_core:core|queued_subop.SUB_CALL  <-  wpms_system:u_sys|wpms_synth_top:u_synth|wpms_l2_top:u_l2|ptsg_core:core|ptsg_imem:ptsg_imem|altsyncram:g_m10k.u_rom|altsyncram_1uc1:auto_generated|altsyncram_fee2:altsyncram1|ram_block3a*~porta_we_reg
          1     -0.961       -0.961      12     9.678  wpms_system:u_sys|wpms_synth_top:u_synth|wpms_l2_top:u_l2|ptsg_core:core|fsm.S_WAIT~DUPLICATE  <-  wpms_system:u_sys|wpms_synth_top:u_synth|wpms_l2_top:u_l2|ptsg_core:core|ptsg_imem:ptsg_imem|altsyncram:g_m10k.u_rom|altsyncram_1uc1:auto_generated|altsyncram_fee2:altsyncram1|ram_block3a*~porta_we_reg
          1     -0.957       -0.957      12     9.681  wpms_system:u_sys|wpms_synth_top:u_synth|wpms_l2_top:u_l2|ptsg_core:core|fsm.S_WAIT  <-  wpms_system:u_sys|wpms_synth_top:u_synth|wpms_l2_top:u_l2|ptsg_core:core|ptsg_imem:ptsg_imem|altsyncram:g_m10k.u_rom|altsyncram_1uc1:auto_generated|altsyncram_fee2:altsyncram1|ram_block3a*~porta_we_reg
          1     -0.896       -0.896      17    20.249  wpms_system:u_sys|wpms_switch:u_sw|ibx_we  <-  wpms_system:u_sys|wpms_switch:u_sw|x_a[]
         13     -0.062       -0.806      10     9.136  wpms_system:u_sys|wpms_synth_top:u_synth|wpms_l2_top:u_l2|ptsg_core:core|stay_target[]  <-  wpms_system:u_sys|wpms_synth_top:u_synth|wpms_l2_top:u_l2|ptsg_core:core|ptsg_imem:ptsg_imem|altsyncram:g_m10k.u_rom|altsyncram_1uc1:auto_generated|altsyncram_fee2:altsyncram1|ram_block3a*~porta_we_reg
          1     -0.620       -0.620      10     9.311  wpms_system:u_sys|wpms_synth_top:u_synth|wpms_l2_top:u_l2|ptsg_core:core|queued_subop.SUB_RETURN  <-  wpms_system:u_sys|wpms_synth_top:u_synth|wpms_l2_top:u_l2|ptsg_core:core|ptsg_imem:ptsg_imem|altsyncram:g_m10k.u_rom|altsyncram_1uc1:auto_generated|altsyncram_fee2:altsyncram1|ram_block3a*~porta_we_reg
          1     -0.356       -0.356       9     9.050  wpms_system:u_sys|wpms_synth_top:u_synth|wpms_l2_top:u_l2|ptsg_core:core|error_flag~DUPLICATE  <-  wpms_system:u_sys|wpms_synth_top:u_synth|wpms_l2_top:u_l2|ptsg_core:core|ptsg_imem:ptsg_imem|altsyncram:g_m10k.u_rom|altsyncram_1uc1:auto_generated|altsyncram_fee2:altsyncram1|ram_block3a*~porta_we_reg
          1     -0.350       -0.350       9     9.052  wpms_system:u_sys|wpms_synth_top:u_synth|wpms_l2_top:u_l2|ptsg_core:core|error_flag  <-  wpms_system:u_sys|wpms_synth_top:u_synth|wpms_l2_top:u_l2|ptsg_core:core|ptsg_imem:ptsg_imem|altsyncram:g_m10k.u_rom|altsyncram_1uc1:auto_generated|altsyncram_fee2:altsyncram1|ram_block3a*~porta_we_reg
          1     -0.335       -0.335      10     9.032  wpms_system:u_sys|wpms_synth_top:u_synth|wpms_l2_top:u_l2|ptsg_core:core|queued_subop.SUB_LOOP  <-  wpms_system:u_sys|wpms_synth_top:u_synth|wpms_l2_top:u_l2|ptsg_core:core|ptsg_imem:ptsg_imem|altsyncram:g_m10k.u_rom|altsyncram_1uc1:auto_generated|altsyncram_fee2:altsyncram1|ram_block3a*~porta_we_reg
          1     -0.271       -0.271      11     8.946  wpms_system:u_sys|wpms_synth_top:u_synth|wpms_l2_top:u_l2|ptsg_core:core|hr_loop[]  <-  wpms_system:u_sys|wpms_synth_top:u_synth|wpms_l2_top:u_l2|ptsg_core:core|ptsg_imem:ptsg_imem|altsyncram:g_m10k.u_rom|altsyncram_1uc1:auto_generated|altsyncram_fee2:altsyncram1|ram_block3a*~porta_we_reg
          1     -0.175       -0.175      10     8.871  wpms_system:u_sys|wpms_synth_top:u_synth|wpms_l2_top:u_l2|ptsg_core:core|fsm.S_PUSH  <-  wpms_system:u_sys|wpms_synth_top:u_synth|wpms_l2_top:u_l2|ptsg_core:core|ptsg_imem:ptsg_imem|altsyncram:g_m10k.u_rom|altsyncram_1uc1:auto_generated|altsyncram_fee2:altsyncram1|ram_block3a*~porta_we_reg
          1     -0.006       -0.006      11     8.723  wpms_system:u_sys|wpms_synth_top:u_synth|wpms_l2_top:u_l2|ptsg_core:core|queued_opcode.OP_BRANCH~DUPLICATE  <-  wpms_system:u_sys|wpms_synth_top:u_synth|wpms_l2_top:u_l2|ptsg_core:core|ptsg_imem:ptsg_imem|altsyncram:g_m10k.u_rom|altsyncram_1uc1:auto_generated|altsyncram_fee2:altsyncram1|ram_block3a*~porta_we_reg

# by the start point of each endpoint's worst path
# endpoints   worst_ns       tns_ns  start group
        270     -2.453     -494.982  wpms_system:u_sys|wpms_switch:u_sw|fired[]
        197     -2.605     -308.394  wpms_system:u_sys|wpms_switch:u_sw|x_a[]
         44     -6.805     -279.176  wpms_system:u_sys|wpms_synth_top:u_synth|wpms_l2_top:u_l2|wpms_formation:form|pmask[][]
        122     -4.812     -129.961  wpms_system:u_sys|wpms_switch:u_sw|ft[]
        113     -2.028     -104.184  wpms_system:u_sys|wpms_synth_top:u_synth|wpms_l2_top:u_l2|ptsg_core:core|ptsg_imem:ptsg_imem|altsyncram:g_m10k.u_rom|altsyncram_1uc1:auto_generated|altsyncram_fee2:altsyncram1|ram_block3a*~porta_we_reg
         46     -1.753      -46.080  wpms_system:u_sys|wpms_synth_top:u_synth|wpms_l2_top:u_l2|wpms_formation:form|copied[]
          5     -6.772      -33.228  wpms_system:u_sys|wpms_synth_top:u_synth|wpms_l2_top:u_l2|wpms_formation:form|a_block[]
          2     -1.170       -2.333  wpms_system:u_sys|wpms_switch:u_sw|x_a[]~DUPLICATE
