dsohnaka/PTSG-WPMS-Formation/04_Verification_Evidence/README.md

# Layer 4 — Verification Evidence / 第4層——検証エビデンス

**CC0.** Where this profile's claims meet DE10-nano (Cyclone V SoC 5CSEBA6U23I7). The profile's numbers so far are instruction counts derived from the master's rows, oracle runs (Layer 3), and — since 2026-09-27 — RTL simulation of the Core the profile runs on. Every number carries its class: **ORACLE** (Python model), **RTL-SIM** (Icarus/ModelSim), **SILICON** (DE10-nano: SignalTap → VCD, and the Fitter's numbers for the device). Timing from Quartus's static analysis of a fitted design is marked **STA**. The first SILICON entry is the resource ledger of the first fit (2026-10-03); no capture exists yet.

**CC0。** 本プロファイルの主張が DE10-nano と出会う場所。これまでの数値は、マスターの行から導いた命令数、オラクル実行（第3層）、そして 2026-09-27 からはプロファイルが載る Core の RTL シミュレーション。数値はすべて証拠クラスを伴う: **ORACLE**・**RTL-SIM**・**SILICON**（SignalTap の取得と、Fitter によるデバイス上の数値）。配置配線後の静的タイミング解析の値は **STA** と記す。最初の SILICON の記載は初回フィットの資源台帳（2026-10-03）で、取得はまだない。

## Entries / 記載

| Date | Entry | Class | Verdict |
|---|---|---|---|
| 2026-09-27 | `SILICON_BRIEF_2026-09-27.md` — the plan for the silicon phase (Layer 4 plan, not evidence) | — | — |
| 2026-09-27 | `reports/phase0_baseline.md` (+ `reports/logs/phase0/`) — golden models and the frozen Core re-run unchanged | ORACLE, RTL-SIM | green |
| 2026-09-27 | `reports/phase1_core.md` + `rtl_sim/2026-09-27_phase1_core_rh031p/` (`observation.md`, VCDs) — PTSG-Core RH031 (provisional) on a copy: bit-identical with the pin silent; SV-0 … SV-7 pass; the anti-pattern caught (8192-clock Stay); packet floor 30 for a 25-instruction window | RTL-SIM | PASS |
| 2026-09-27 | `reports/phase2_datapath.md` + `rtl_sim/2026-09-27_phase2_l2_datapath/` (`observation.md`, logs) — the L2 Formation datapath bit-identical to `pfasm_tools_w.Machine` on 3,914 cases (105,519 instructions); `exp_maclaurin_w` 7.39e-09; 13 negatives; 20/20 mutants caught; the score round trip on the Core copy; SD-13, SD-14 filed; resources by Yosys (ESTIMATE) | RTL-SIM | PASS |
| 2026-09-28 | `reports/phase3_integration.md` + `rtl_sim/2026-09-28_phase3_l2_integration/` (`observation.md`, logs) — Core + Formation + sequencer running the R1 score: every latched bundle, N, K sequence and `stay_value` identical to `sweep_sim.py` over 36,000 sweeps at the 100 MHz and at the 50 MHz budget (dispatch form: g = 0, T_wake 1; worst full-load sweep 2,062/2,083 and 1,038/1,041); EW2–EW6 silence L1 at once, the Core halts at the trap; R2 probe (SD-04); SD-15 filed; 11/11 sweep-level mutants caught | RTL-SIM | PASS |
| 2026-09-29 | `reports/phase4_l1.md` + `rtl_sim/2026-09-29_phase4_l1/` (`observation.md`, logs) — the L1 pipeline and the output path: bit-exact with the customer's oracle (phase, exp2, amplitude with MG, MG slew) and with the published model of sin, product, accumulators and output stage — 1,000,000 unit inputs each, 651,424 module bins, the whole synthesizer under the sweep oracle's traffic and on the 48 kHz I2S grid (wire decoded); 927 audible bins; test-origin peak −6.29 dBFS; MG −60 dB in 1.0000 s; latency 21.484 µs; D_L1 = 19; 23/23 mutants; SD-16 … SD-18 filed; about 16 DSP + 1 M10K per module (ESTIMATE) | RTL-SIM | PASS |
| 2026-09-29 | `rtl_sim/2026-09-29_sd15_insert_handshake/` (`observation.md`, VCDs, log) — SD-15 reproduced on the **frozen** PTSG-Core source with a six-word program: a request dropped at the edge that samples `insert_ack` is accepted twice (S_PUSH with no stack; two acks and a spurious push with one); withdrawn within the ack clock, once. Bug report to the Core's office (ruling 2026-09-29) | RTL-SIM | REPRODUCED |
| 2026-09-30 | `reports/phase5_switch.md` + `rtl_sim/2026-09-30_phase5_switch/` (`observation.md`, logs, VCD) — the minimal input switch of customer Ch.5 with the host path over ISSP/JTAG (ruling 2026-09-30): the ROM's test origin (N = 1,008 at 50 MHz), stage-arm-go with an atomic hand-over (Formation RH004), PR-1/PR-2/sum-of-N checks, APPLIED_SEQ/SAMPLE. Fifteen system runs at both budgets: 17,679 transactions and 6,664 inbox-port writes equal to the switch model; 4,209 bundles and 2,378 samples bit-exact with `sweep_sim.Reference` and the customer's oracle; 960 GOs each playing from the second strobe after acceptance; the music script of Phase 6 played, and its Tcl run under tclsh against stand-ins of the ISSP commands (not Quartus); 22/22 mutants; SD-19 … SD-21 filed; the ADV7513 table checked against the programming guide's pages | RTL-SIM | PASS |
| 2026-10-01 | `reports/phase6_silicon.md` (part 1: before the board) + `rtl_sim/2026-10-01_phase6_board/` (`observation.md`, logs, `expected/`: per case and budget the RTL-SIM values and the capture as SignalTap will hold it) — the DE10-nano top (three PLLs, resets, HDMI carrier and ADV7513 configurator, I2S + MCLK, LEDs, ISSP BRD, SignalTap taps), its Quartus project (revisions 50 / 100 MHz) and SDC. On the board-level bench, at both budgets, the brief's eight items within their bounds: g 0; T_wake 2; window 28, floor 30; BCP 10 with the full take-set (the bound); full-load sweep 1,023 / 1,041 and 2,063 / 2,083; EW2–EW6 each with its code, L1 silent, the Core halted; 1,065 bundles and 2,636 banks bit-exact with the models; the triad's spectrum the model's. Each run cut as its SignalTap capture and read back. The project checked with stand-ins (tclsh, Icarus), not Quartus | RTL-SIM | PASS (the board pending) |
| 2026-10-01 | `signaltap/phase6_pending/` — the observation templates of captures C1–C5, the Expected column (the brief's bounds, the RTL-SIM values) written before any capture | — | filled 2026-10-04 in `signaltap/2026-10-04_phase6_*/` |
| 2026-10-01 | `reports/customer_note_sd19_host_path.md` — the note for the customer team on the host path (ruling 2026-10-01: ISSP carrying addressable port-0 transactions is adopted; the profile overrides C5-D8 here) | — | prepared |
| 2026-09-30 | `reports/customer_note_sd16_sin.md` — the note for the customer team on the L1 sine (ruling 2026-09-30: the published realization is the official specification) | — | prepared |
| 2026-10-03 | `quartus/2026-10-03_DE10_Nano_wpms_fit1/` (`observation.md`, `ledger.md`, the two Quartus reports) + `reports/phase6_silicon.md` §8–§9 — the first compile of the 50 MHz revision. After the configurator's RH003 (two drivers of `nack`: Quartus error 10028), Quartus Prime Lite 23.1std.1 completes. The resource ledger: 11,052.8 ALMs, 15,318 registers, 22 M10K, 23 DSP; the Formation 6,788.7 ALMs; PTSG-Core RH031p 457.7 (414.3). Timing: every clock meets but clk_sys, −14.307 ns (TNS −65,525 ns): the Formation's one-clock execute (SD-22) | SILICON (resources), STA | ledger recorded; timing open (SD-22) |
| 2026-10-03 | `rtl_sim/2026-10-03_sd22_step1/` (`observation.md`, logs) + `reports/phase6_silicon.md` §10 — SD-22 step 1 (ruling 2026-10-03). Formation RH005 and switch RH002 restructure the long paths of the first fit (per-register enables, the address decode registered, the sums of N as trees). Behaviour unchanged: 0 differences against the previous revisions in every clock over 3.2 M clocks of random stimulus; the restructured logic proved equal (5/5, SAT); Phases 2–6 repeat the record (the 18 board runs and the 16 expected captures identical), 23/23 mutants. Gate depth (ESTIMATE): the store 136 → 33 levels, longest 146 → 112 | RTL-SIM, formal, ESTIMATE | PASS (the second fit pending) |
| 2026-10-03 | `quartus/2026-10-03_DE10_Nano_wpms_fit2/` (`observation.md`, the Multicorner summary, the worst path, the grouped report `setup_clk_sys_groups.txt` and the key paths `setup_clk_sys_keys.rpt`) — the second compile (SD-22 step 1): clk_sys −6.976 ns, TNS −1,509 ns (the first: −14.307, −65,525); every other clock meets. 799 failing endpoints in four groups: the switch's GO check (−2.6 ns), MUL/MAC @PPM (−6.8), BCP's EW5 (−4.8), and the Core's imem half-cycle path (−2.0; SD-23) | STA | timing open (SD-22 step 2, SD-23) |
| 2026-10-03 | `rtl_sim/2026-10-03_sd22_step2/` (`observation.md`, logs) + `reports/phase6_silicon.md` §11 — SD-22 step 2 (ruling 2026-10-03) and SD-23. Formation RH006: the E8 of MUL/MAC decided in the next clock (Accm restored, the next instruction squashed), the operand and EW5's sum computed one clock ahead. Switch RH003: the GO check from the request's fields, its sum by carry-save adders. clk_sys 30 % high in the 50 MHz revision. Lockstep: 0 differences in 8 runs of 400,000 clocks, the two late errors with the reference's code and SN; 13/13 proved (SAT); Phase 2 3,923/3,923, 29/29 mutants; Phases 3–6 repeat the record (the 18 board runs and the 34 expected files identical). Depth (ESTIMATE): the error registers 44 → 14–16 LUT levels, the switch's results 16 → 13; the Formation +2,030 LUTs | RTL-SIM, formal, ESTIMATE | PASS (the third fit pending) |
| 2026-10-03 | `signaltap/2026-10-03_first_sound/` (`observation.md`) + `reports/phase6_silicon.md` §12 — the first sound. The architect programmed the board and heard and saw the test origin through HDMI (an audio extractor, an oscilloscope, a loudspeaker): about 1 kHz, amplitude-modulated every 250 ms, slowly changing, very stable. As expected from the ROM's integers: 997.97 Hz, nulls every 253.62 ms, a 255.65 s cycle. The bitstream is the second fit's: timing not closed | SILICON (qualitative) | consistent; the captures C1–C5 pending |
| 2026-10-03 | `signaltap/2026-10-03_core_debug/` (`observation.md`, the capture, `vcd_i2s_check.txt`) + `reports/phase6_silicon.md` §12 — the architect's SignalTap capture `ptsg_core_debug`. The Core's packet Stay is 1,008 clocks every sweep; the sweep period is 1,041/1,042 clocks, locked to the I2S frames. **The 8 audio frames on the I2S pins equal the model bit for bit**, 39,684,738 sweeps after the GO, at G = 0 (DIP[1:0] = 00). So 40 million phase updates in the Formation's store were all right. The build is not timing-closed | SILICON | bit-exact |
| 2026-10-04 | `quartus/2026-10-04_DE10_Nano_wpms_fit3/` (`observation.md`, `ledger.md`, the Multicorner summary, the 10 worst clk_sys paths, the resource report) + `reports/phase6_silicon.md` §13 — the third compile (SD-22 step 2, SD-23). **clk_sys closes: setup +0.978 ns, TNS 0** (Slow 1100 mV 0 °C), hold +0.042 ns; every clock meets. The 10 worst endpoints are all MAC into `w_hi` (18.8 ns). The 30 % duty cycle is set as asked. Ledger: 11,321.7 ALMs, the Formation 7,048.0, 22 M10K, 23 DSP | STA, SILICON (resources) | **timing met at 50 MHz** |
| 2026-10-04 | `signaltap/2026-10-03_first_sound/` (addendum) + `reports/phase6_silicon.md` §14 — at SW[1:0] = 11 (G = 12) the architect sees "a perfectly beautiful Dirichlet kernel", its main lobe about every 4 min 15 s: the cycle predicted on 2026-10-03 from the ROM's integers is 255.65 s = 4 min 15.7 s | SILICON (qualitative) | as predicted |
| 2026-10-04 | `signaltap/2026-10-04_phase6_C1_origin/`, `…_C2_full8/`, `…_C3_first_go/`, `…_C4_ew6/`, `…_C5_ew2/` … `…_C5_ew5/` (`observation.md`, the export, the host log, `observed.json`; C2 also the architect's own report) + `reports/phase6_silicon.md` §15 — the planned SignalTap captures, taken by the architect on the 50 MHz revision. Every value measured equals the RTL-SIM value written on 2026-10-01: g 0, T_wake 2, floor 30, BCP 10, full-load sweep 1,023 clocks; EW2–EW6 each with its code, silence and halt to the clock; 45 bundles and 12 banks equal to the model. C3: the chord after the GO heard as C major; its storage qualifier did not follow `tap_ctl[100]` (the port held as a pin), and its captured values equal the model | SILICON | as expected |
| 2026-10-04 | `quartus/2026-10-04_DE10_Nano_wpms_signaltap/` (`observation.md`, the Multicorner summary) — the SignalTap build on which C2–C5 were taken: every clock meets, clk_sys +0.557 ns, TNS 0 | STA | closed |
| 2026-10-15 | `reports/gui_board.md` + `host_gui/2026-10-15_board/` (step logs, transaction times, replays, `board_stats.txt`) — **OUTSIDE WPMS**: the host control GUI (`hw/tools/host/gui/`) on the board. One ISSP transaction 0.41 ms mean (3.5 ms max over 1,000; 92.8 % < 0.5 ms over 132,831); master gain 1,826 updates/s; 374 block-level GOs/s on four blocks with the apply confirmed before each next GO; REJECT[0] 0 throughout; no clicks, no zipper noise, PANIC at exactly 60 dB/s (by ear and MG read-back); both sessions replayed in RTL-SIM: PASS (22,450 and 2,808 GOs, 0 host writes refused, 67,816 and 9,571 samples equal the models); a screenshot and a recording of 2026-10-18 (`media/`: each block's main lobe returns every 16.00 s; a 250 Hz comb at −57 dBFS between the bursts, traced by the architect to the recording chain's HDMI audio splitter: outside WPMS) | SILICON, RTL-SIM | green |
| 2026-10-19 | `reports/lab_v1.md` + `rtl_sim/2026-10-19_lab_phase_a/` — **OUTSIDE WPMS**: WPMS Lab Phase A (`hw/tools/host/lab/`), a sound-design tool on the GUI's controller (one seam, `gui/wpms_ctl.py` RH003, ruling 2026-10-19). Expected written first. V-L1 11/11 against the customer's oracle (Schroeder identity; window = `gaussian()` bit for bit at k_c = N/2, not at the brief's (N−1)/2; headroom estimate within 10⁻⁵ dB); V-L2 3/3 (500 random Lab moves, presets, phase seeding: REJECT[0] 0); V-L3 the Lab's log through the switch RTL: 0 refused, 533/533 samples; V-L4 the GUI unchanged (9/9 mutants, board_gui.json replay as on 2026-10-15). Board session (B-L) to come | ORACLE, RTL-SIM | green |
| 2026-09-27 | `reports/discrepancies.md` — SD-01 … SD-23, filed, not fixed; rulings of 2026-09-28, 2026-09-29, 2026-09-30, 2026-10-01, 2026-10-03 and 2026-10-04 recorded | — | open |

## Layout / 構成

```
04_Verification_Evidence/
├── SILICON_BRIEF_2026-09-27.md      the plan (Layer 4 plan, not evidence)
├── reports/                          one report per phase, bilingual; discrepancies.md; logs/
├── rtl_sim/<date>_<feature>/         RTL-SIM evidence: observation.md + small VCDs + logs
├── quartus/<date>_<revision>_fit<n>/ a fit: the Quartus reports, the resource ledger, observation.md (Phase 6)
├── signaltap/<date>_<feature>/       SILICON evidence: VCD + observation.md (Phase 6)
├── host_gui/<date>_board/           SILICON evidence of the host GUI (outside WPMS): step logs, transaction times
├── host_lab/<date>_board/           SILICON evidence of WPMS Lab (outside WPMS), when a session exists
└── signaltap/phase6_pending/        the Phase 6 captures' templates, Expected filled before capture
```

*Measured, not promised.* / *約束せず、測って刻む。*
