dsohnaka/PTSG-WPMS-Formation/04_Verification_Evidence/signaltap/phase6_pending/C5_ew5/observation.md

# C5 — ew5: EW5 injected (ISMCE image: N = NMAX + 1; BCP re-checks the sum) / EW5 注入（ISMCE 像：N = NMAX + 1、BCP が総和を再検査） — PENDING

**Evidence class once filled: SILICON.** The Expected columns were written on 2026-10-01, before any capture: the brief's bound, and the RTL-SIM value of the same capture cut from the board-level bench (`hw/tools/cosim_board.py`, the same RTL and host steps; `04_Verification_Evidence/rtl_sim/2026-10-01_phase6_board/expected/ew5_<budget>.json` and `expected_ew5_<budget>.vcd.gz`). Fill the Observed column from `phase6_evidence.py`; a difference goes to `reports/discrepancies.md`, not into the design.

**記入後の証拠クラスは SILICON。** 期待値の欄は取得前の 2026-10-01 に記録した。内容は指示書の上限と、基板レベル試験台で同じ取得を切り出した RTL-SIM の値。観測値は `phase6_evidence.py` の出力で埋める。差異は設計を直さず `reports/discrepancies.md` に記録する。

| | |
|---|---|
| Board, revision | DE10-nano 5CSEBA6U23I7; revision ____ (`DE10_Nano_wpms` 50 MHz / `DE10_Nano_wpms100` 100 MHz) |
| Date and time | ____ |
| Bitstream | `output_files/____.sof`, Quartus Prime Lite 23.1std.1, commit ____ |
| Switches | SW[1:0] = 11, both up (G = 12, which the expected values assume); SW[2] = 0; SW[3] = 0 |
| SignalTap | `wpms_tap.stp`: clk_sys, depth 4,096, pre trigger position (12 %); trigger `tap_ctl[4]` rising (error_flag); storage qualifier disabled |
| Action | BRD source[0] → 1; ISMCE PTSG ◂ `inject/wpms_r1d_ew5_<NMAX>.mif`; arm; source[0] → 0; afterwards restore `wpms_r1d.mif` |
| Files here | `C5_ew5.vcd.gz` (the export; if it fails, the `.stp` saved after the acquisition, converted by `hw/tools/stp_log_to_vcd.py`), the host log if any, `reset.log` (the one line `RESET`: the model starts from reset), `observed.json` |
| Analysis | `python3 hw/tools/phase6_evidence.py C5_ew5.vcd.gz --budget 50|100 --log reset.log --score hw/de10_nano/inject/wpms_r1d_ew5_<NMAX>.score --json observed.json` |

## Expected and observed / 期待値と観測値

| Item | Quantity | Bound (brief) | RTL-SIM 50 MHz | RTL-SIM 100 MHz | Observed (SILICON) | Verdict |
|---|---|---|---|---|---|---|
| 6 | error_flag: code | EW5 | EW5 | EW5 | | |
| 6 | after the flag: packet_start, bin_valid, non-zero banks (L1 silent) | 0, 0, 0 | 0, 0, 0 | 0, 0, 0 | | |
| 6 | the Core halts (LED[5]); clocks after the flag | halts | 11 | 11 | | |

## Notes / 所見

(pending)
