dsohnaka/PTSG-WPMS-Formation/04_Verification_Evidence/rtl_sim/2026-10-19_lab_phase_a/wpms_lab_standin.png

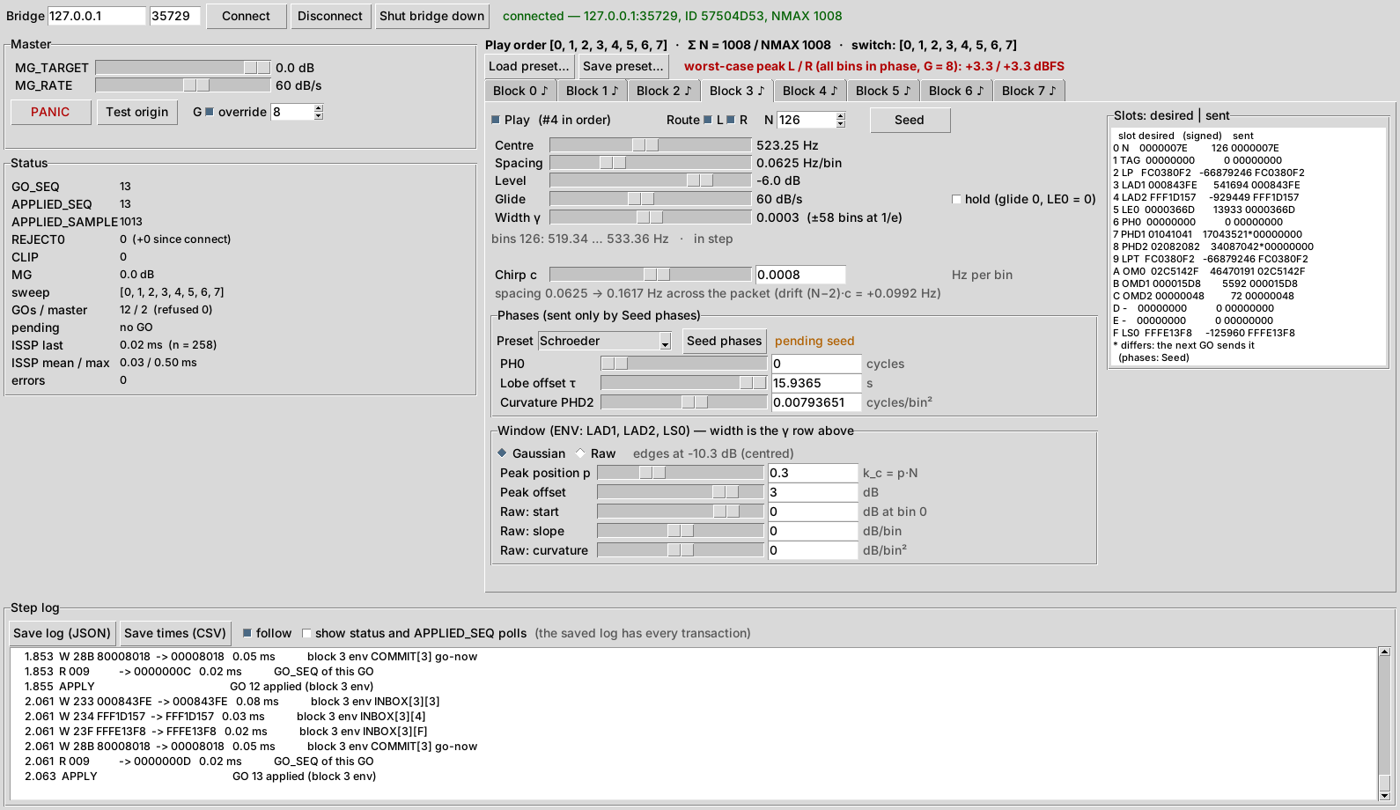
04_Verification_Evidence/rtl_sim/2026-10-19_lab_phase_a/wpms_lab_standin.png
