dsohnaka/PTSG-WPMS-Formation/03_Sample_Implementations/hw/de10_nano/make_quartus_project.py

#!/usr/bin/env python3
# ============================================================================
# make_quartus_project.py — the Quartus Prime project of the WPMS silicon
# sample (SILICON_BRIEF_2026-09-27 Phase 6): one flat directory holding every
# source, include file and memory image, the SDC, and two revisions of one
# project, as the Core's harness keeps its files side by side.
#
#   python3 make_quartus_project.py [--out DIR] [--sys-duty PCT] [--no-signaltap] [--check [--mutants]]
#                                   [--tclsh tclsh8.6]
#
#   DE10_Nano_wpms      SYS_MHZ  50: clk_sys 50 MHz, NMAX 1,008 (the
#                       effective target, rulings 2026-09-28/29);
#                       SYS_DUTY 30: clk_sys high 6 ns, low 14 ns (SD-23)
#   DE10_Nano_wpms100   SYS_MHZ 100: clk_sys 100 MHz, NMAX 2,048; SYS_DUTY 50
#
# The revisions differ in two integers (set_parameter -name SYS_MHZ, SYS_DUTY);
# the top derives the PLL frequency and the ROM image from the first, and
# gives the second to the PLL as clk_sys's duty cycle. SD-23: the Core's imem
# (ptsg_imem, EDGE "NEG") reads on clk_sys's falling edge, and the Core's
# registers take the word at the next rising edge; at 50 % that is 10 ns, which
# the second fit missed by 2.0 ns. A falling edge 6 ns after the rising one
# gives that path 14 ns and the address path into the M10K, a register
# straight into the block, 6 ns. --sys-duty 50 builds the 50 MHz revision as
# the first two fits had it. Also copied: the
# injection images (inject/, for the In-System Memory Content Editor) and the
# host scripts (host/, for quartus_stp). MANIFEST.txt records each file's
# source and SHA-256, and the commit it was taken from.
#
# SignalTap: wpms_tap.stp (the architect's, 2026-10-04) is enabled in the 50 MHz
# revision (ENABLE_SIGNALTAP, USE_SIGNALTAP_FILE, SIGNALTAP_FILE). It is copied
# only when the project directory has none: a .stp there, edited in the
# GUI or holding acquisitions, is kept. --no-signaltap leaves SignalTap out.
#
# --check also runs the project's Tcl (both .qsf and the .sdc) under a plain
# tclsh against stand-ins of the Quartus commands, with the clock names
# derive_pll_clocks gives a Cyclone V altera_pll, and checks: every port of
# the top has one pin and an I/O standard, no pin twice, the pins equal the
# Terasic golden top's (the Core's .qsf, when the Core is beside us), every
# file named exists, and the SDC finds the three PLLs, the forwarded clock,
# and puts every clock in exactly one asynchronous group. It then elaborates
# the project's Verilog (the very files Quartus gets) with Icarus, the INTEL
# branches taken and the Intel primitives stood in (sim/vendor_stubs.v), and
# checks the parameters each PLL, memory and ISSP instance receives, per
# revision. --mutants: seven broken copies of the project (a pin, a file,
# four SDC defects, an I/O standard), each of which --check must catch.
# A stand-in is not Quartus: this proves the Tcl runs and the Verilog
# elaborates as meant, nothing more.
# License: MIT (Layer 3 tooling).
# ----------------------------------------------------------------------------
# REVISION HISTORY(RH)
# 001 2026-10-01       Claude Code   Add : First version (SILICON_BRIEF Phase 6).
# 002 2026-10-03       Claude Code   Add : report_setup_paths.tcl copied beside the project.
# 003 2026-10-03       Claude Code   Add : SYS_DUTY per revision (SD-23), --sys-duty; the checks follow it.
# 004 2026-10-04       Claude Code   Add : wpms_tap.stp, copied once and enabled in the 50 MHz revision;
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
