dsohnaka/PTSG-WPMS-Formation/(commit log)

2026-09-27 Phase 1: PTSG-Core RH031 (provisional) on a copy — stay_value form B, SV-0..SV-7
    SILICON_BRIEF_2026-09-27 Phase 1. The frozen PTSG-Core ptsg_core.v (RH030,
    1b58ebc) is untouched; all work is on hw/core/ptsg_core_rh031p.v.
    RTL (hw/core/ptsg_core_rh031p.v, module ptsg_core; diff +64/-8):
    - RH029/030 header and tag corrections exactly as RH029-030_header_patch.md
    (comments/whitespace only).
    - stay_value, form B (C4-T5 lean): input tri0 [CNT_W-1:0] stay_value;
    stay_dur_lit + IND-reverse mux as the single substitution point
    (C4-F15, C4-F16, C4-F17 >=, C5-F4 one sample); width CNT_W = 12
    (C5-T2 lean, the profile's answer: longest Stay 2,048).
    - Draft RH031 entry per stay_value_reference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
    [ptsg_core_rh031p.v, ptsg_core_sv_tb.v, vcd_compare.py, vcd_dump.v]
2026-09-27 Phase 2: L2 Formation datapath (wpms_formation.v), decode map, assemblers, cosimulation
    The Formation side of the nine-lane border for this profile (W-F1, W-F22..W-F30,
    W-R12..W-R16; Register Map v0.3 §2-§4, §7-§9), per SILICON_BRIEF_2026-09-27 Phase 2.
    - hw/l2/wpms_formation.v: issue register + execute (latency 2, throughput 1;
    IF-1, IF-2, F-F10); Accm/Temp/ADRS/SHV; sources IMM..SSS (SSS via tap_sss,
    SD-03; I 16-bit, SD-07); the 9-bit L2 space incl. CUR alias, COMMIT view,
    sweep words, status; slot-major store and inbox; STP (W-F26); BCP (W-F27)
    architectural in one clock with a background copy, forwarding and
    write-cancel, inbox_taken (CR5-I3) when the copy lands; E4/E5/E8/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
    [cosim_l2.py, cosim_mutants.py, gen_decode.py, pfasm_as.py, score_as.py, score_rt.py, score_rt_tb.v, wpms_formation.v]
2026-09-28 Phase 3: sweep sequencer and L2 integration (Core RH031p + Formation + sequencer), R1 score
    Per SILICON_BRIEF_2026-09-27 Phase 3 and the rulings of 2026-09-28 (SD-13 (a),
    SD-14 (a), SD-06 insertion with L1 silenced at once, 50 MHz fallback budget).
    - hw/l2/wpms_sequencer.v (W-F28, W-F19/W-R16, W-F22): packet index, CUR,
    lanes STROBE/NONEMPTY/MORE, StayVal.s/StayVal.p -> stay_value (C4-F16),
    bundle prefetch (CR3-B1), SSS label (SD-03), L1 face one clock after the
    Core (SD-11), l1_mute = error_flag.
    - hw/l2/wpms_l2_top.v: Core + Formation + sequencer; JumpVal/LoopVal on the
    Core's indirect-read bus (lane 5); insertion to the trap word (C3-F24).
    - Scores (W-R17): R1 dispatch form (queu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
    [cosim_sweep.py, cosim_sweep_mutants.py, r2_probe.py, score_as.py, score_rt_tb.v, sweep_dump.py, wpms_formation.v, wpms_l2_tb.v]
2026-09-29 Rulings of 2026-09-29 recorded; SD-15 bug report: insertion handshake reproduced on the frozen Core
    - discrepancies.md: rulings of 2026-09-29 — dispatch form (wpms_r1d) is the
    standard score for Phase 4 on; NMAX = 1,008 at 50 MHz; SD-04 ruled (no
    INT-R1 request for now, g = 0 met by the dispatch form); SD-15 workaround
    approved and conveyed to the Core's office as a bug report; LoopVal stays on
    the indirect-read bus (purpose 01).
    - hw/core/sd15_insert_handshake_tb.v, run_sd15.sh: minimal reproduction of
    SD-15 (Core Ch.5 §5.9, C3-F20, C3-F23/F24) on the FROZEN PTSG-Core source
    (read only, sha256 recorded) and on the RH031p copy: a request dropped at the
    edge that samples inse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
    [sd15_insert_handshake_tb.v]
2026-09-29 Phase 4: L1 pipeline and output path (hw/l1), bit-exact with the customer's oracle
    L1 (customer Ch.3 §3.4-§3.7; CR3-B1, CR3-R1, CR3-T3; C3-D3..D11), one module:
    - wpms_l1_module.v: bundle latch at packet_start; phase engine mod 2^32 and
    shape engine 54-bit Q.30 with MG in the level (Ch.4 §4.4.1); product Q1.71 ->
    Q1.63 toward zero; accumulators Q12.63 routed by RT.OUT, closed on the strobe
    (C3-D9); overrun flag, SWEEP_CLOCKS (Ch.4 §4.9), inspector (Ch.5 0x040);
    silence on the Formation's error_flag (ruling 2026-09-28). D_L1 = 19.
    - wpms_l1_exp2.v: the oracle's exp2_q131 bit for bit (table in one M10K).
    - wpms_l1_sin.v: the Maclaurin core (Ch.2 v1.1, C2-D1..D11): 16 clocks, 7
    mu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
    [cosim_l1.py, cosim_l1_mutants.py, cosim_synth.py, gen_l1_tables.py, l1_model.py, wpms_adv7513_cfg.v, wpms_adv7513_tb.v, wpms_formation.v]
2026-09-30 Phase 5 (in progress): the minimal input switch (hw/switch) with the ISSP host path
    Switch (customer Ch.5 §5.4-§5.8; CR5-R1, CR5-I1..I3, CR5-S1; W v0.7 PR-1,
    PR-2), one module (M = 1), port 0 = host, port 3 = built-in ROM:
    - wpms_switch.v: the whole §5.6 map for module 0 and Ch.4's knobs;
    stage-arm-go with freezing from arm until applied; GO, GO_ALL, go-now,
    KEY[0]; PR-1, PR-2 and the sum of N checked when a GO fires (a refused
    GO disarms its items); the fired set handed to the Formation in one
    clock; the apply step at inbox-taken (CR5-I3); APPLIED_SEQ,
    APPLIED_SAMPLE, SAMPLE, REJECT[0/3]; the ROM player (CR5-R1).
    - Host path per the architect's ruling of 2026-09-30 (SD-19): ISS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
2026-09-30 Phase 5: the final recorded run, with the host-script check and its mutants
    run_phase5.sh recorded at 2026-09-30T14:16:21Z (RTL-SIM): ALL PHASE 5
    CHECKS PASSED. The switch, bridge, ROM and sound results are those of
    the first two recordings line for line (only run times differ; the VCD
    differs only in its date).
    check_host_tcl.py (hw/tools/host, outside WPMS) now also breaks
    wpms_issp_host.tcl eight ways; each copy fails a case (8/8), recorded in
    logs/check_host_tcl.txt. Observation E14 filled; phase5_switch.md §2
    updated. The Phases 2-4 regression on Formation RH004 (SD-21): the
    Phase 2 and Phase 3 recipes passed; Phase 4 is still running and follows
    in the next commit.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
2026-10-01 Phase 6 part 1 (in progress): DE10-nano board top, Quartus project, SDC, board-level RTL-SIM
    SILICON_BRIEF_2026-09-27 Phase 6, everything before the board:
    - hw/de10_nano: the board top around wpms_system — PLLs (clk_sys 50/100 MHz;
    MCLK 12.288 MHz fractional, C4-D2; pixel 74.25 MHz at 0 and 180 degrees,
    fractional, the 720p60 carrier of C4-D9), resets (power-on, lock, SW[2]
    per Ch.5 §5.8, ISSP BRD), the ADV7513 configurator, I2S + MCLK (C4-D8),
    LEDs (C3-F24 halt shown), SignalTap taps; wpms_pll (altera_pll direct, as
    the Core's harness); the SDC (async groups by PLL instance, HDMI pixel bus
    against the forwarded clock, the imem half-cycle path not waived); the
    Quartus proje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
    [DE10_Nano_wpms_tb.v, DE10_Nano_wpms_top.v, cosim_board.py, gen_inject_scores.py, make_quartus_project.py, phase6_evidence.py, phase6_templates.py]
2026-10-01 Phase 6 part 1: the recorded run, its evidence and the capture templates
    SILICON_BRIEF_2026-09-27 Phase 6, before the board — run_phase6.sh, all green:
    - regression (2026-10-01T13:43:18Z, the same RTL): ALL PHASE 2, 3, 4 and 5
    CHECKS PASSED on wpms_system RH002;
    - the recorded run (14:45:10Z): injection images regenerate; the six Phase 6
    host scripts make exactly their steps (8/8 host mutants); the Quartus
    project under stand-ins (pins = golden top, SDC groups, hdmi_tx_clk, the
    INTEL elaboration) with 7/7 project mutants; cosim_board 18 runs, 0 failed
    checks — the brief's eight items within their bounds at both budgets
    (g 0, T_wake 2, floor 30, BCP 10 with the full take-set,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
2026-10-03 wpms_adv7513_cfg RH003: one driver for the sticky nack (Quartus error 10028)
    The architect's first Quartus compile (DE10_Nano_wpms) stopped in Analysis &
    Synthesis: "Can't resolve multiple constant drivers for net nack" — the top
    FSM cleared it at reset, the transaction engine set it (Icarus accepts two
    procedural drivers). The engine now raises a one-clock nack_ev and the top
    FSM alone owns nack (C4-D9 configurator, Ch.4 §4.6.2). Checked: Phase 4's
    ADV7513 bench PASS; a bench with no slave sets nack, keeps it, clears it on
    reset; cosim_board origin at both budgets PASS; make_quartus_project --check
    --mutants PASS. No other register of the RTL has two drivers.
    Report phase6_silicon.md §8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
    [wpms_adv7513_cfg.v]
2026-10-03 Phase 6: the first fit recorded; clk_sys at 50 MHz filed as SD-22
    The architect's first full compile (Quartus Prime Lite 23.1std.1, revision
    DE10_Nano_wpms, 50 MHz) after the configurator's RH003.
    - quartus/2026-10-03_DE10_Nano_wpms_fit1/: the timing summary and the
    resource report, the ledger in the Core's format (resource_ledger.py),
    and observation.md (expectations quoted from before the compile).
    Ledger: 11,052.8 ALMs, 15,318 registers, 22 M10K, 23 DSP; Formation
    6,788.7 ALMs; Core RH031p 457.7 (414.3).
    - Timing: every clock meets except clk_sys, setup -14.307 ns (TNS
    -65,525 ns). Filed as SD-22, open for the architect's ruling, no fix
    applied. The Formation's one-clock exec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
    [make_quartus_project.py]
2026-10-03 SD-22 step 1: Formation RH005, switch RH002 — long paths restructured, behaviour unchanged
    Ruling 2026-10-03: step 1 now; step 2 without a new round if step 1 does
    not close timing.
    - wpms_formation RH005:
    (a) Each register's enable comes from the errors its own instructions
    can raise, instead of one commit of every instruction. The store,
    the background copy, the pending masks and ADRS no longer wait for
    the multiplier's overflow.
    (b) The address decode (region, a_block) is registered with ADRS and
    x_cur.
    (c) EW5's sum of N is a balanced tree; the repeat check is pairwise.
    In simulation, a check compares the split enables with RH004's commit
    in every clo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
    [cosim_mutants.py, cosim_switch_mutants.py, equiv_formal.py, equiv_lockstep.py, gate_depth.py, wpms_formation.v, wpms_formation_tb.v, wpms_switch.v]
2026-10-03 SD-22 step 1: Phases 2-6 repeat the record of 2026-10-01
    run_phase6.sh with REGRESSION=1 on Formation RH005 and switch RH002:
    ALL PHASE 2, 3, 4, 5 and 6 CHECKS PASSED.
    Against the recorded run (new tool compare_regression.py):
    - identical: Phase 3's log, the 18 board runs (cosim_board.txt), and all
    34 expected files (18 JSON by value, 16 captures byte for byte), so the
    board's taps are the same cycle for cycle;
    - the only other differences are explained: the resource ESTIMATE lines,
    Phase 2's 23/23 mutants (20/20 recorded), the regression lines of
    run_phase6.txt (the record ran REGRESSION=0), and the moved line numbers
    of the same compiler notes.
    The logs and the comparison are i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
2026-10-03 SD-22 step 2: Formation RH006, switch RH003 — the long paths cut at a clock edge
    Ruling 2026-10-03: if step 1 does not close timing, step 2 follows
    without a new round, and for it the 2026-09-28 "no pipelining of the
    long paths now" is lifted. The second fit (step 1) is short by 6.976 ns
    in four groups of paths.
    - wpms_formation RH006:
    (a) The E8 of MUL and MAC is decided in the clock after X (stage W).
    Accm is written in X and restored from a one-clock copy on E8,
    and the instruction then in X is squashed. A prefetch's EW2 met
    in a MUL's or MAC's X clock waits one clock (pf_w), so the MUL's
    E8 keeps its priority. Both errors keep their code and SN and are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
    [cosim_l2.py, cosim_mutants.py, cosim_sweep.py, cosim_switch_mutants.py, equiv_formal.py, equiv_lockstep.py, gate_depth.py, wpms_formation.v]
2026-10-03 SD-23: clk_sys 30 % high in the 50 MHz revision (the Core's imem half-cycle path)
    The second fit: 113 Core endpoints fail by up to 2.028 ns on the imem's
    half-cycle path. The M10K is read on clk_sys's falling edge
    (ptsg_imem, EDGE "NEG"); its word goes through the Core's next-state
    logic to the next rising edge, which is 10 ns away at 50 %. The Core and
    its wrapper are frozen, so the board's PLL makes clk_sys 30 % high: the
    read side gets 14 ns, the address side 6 ns. TimeQuest analyzes the
    real waveform (derive_pll_clocks); nothing is relaxed or waived.
    - wpms_pll RH002: DUTY0, given to altera_pll as duty_cycle0.
    - DE10_Nano_wpms_top RH002: SYS_DUTY (default 50), to the clk_sys PLL.
    - make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
    [DE10_Nano_wpms_top.v, make_quartus_project.py, vendor_stubs.v, wpms_pll.v]
2026-10-03 Phase 6: the architect's SignalTap capture — the I2S words equal the model bit for bit
    The architect's capture ptsg_core_debug: 8,192 samples of clk_sys with the
    Core's state_num, timing_signals and stay_cnt, and the I2S pins.
    - The Core's packet Stay is 1,008 clocks in every sweep. The sweep period
    is 1,041 or 1,042 clocks (mean 1,041.71), locked to the I2S frames.
    - The 8 audio frames on the wire equal the model of the test origin bit
    for bit (L = R), 39,684,738 sweeps after the GO, at G = 0
    (DIP[1:0] = 00). The phases accumulate in the Formation's store, so 40
    million updates were all right on this build, which is not
    timing-closed.
    - G = 0 is 72 dB above the level the RTL-SIM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
2026-10-03 SD-22 step 2: Phases 2-6 repeat the record (the board's 18 runs and 34 expected files identical)
    run_phase6.sh with REGRESSION=1 on Formation RH006 and switch RH003:
    Against the recorded run of 2026-10-01 (compare_regression.py):
    - Identical: the 18 board runs (cosim_board.txt) and all 34 expected
    files (18 JSON by value, 16 captures byte for byte), so the board's
    taps are the same cycle for cycle. The host scripts' check and the
    injection images are identical too.
    - The other differences are explained:
    - Phase 2's group late (9 cases) and its 29/29 mutants;
    - the switch's 23/23 mutants (W23 new);
    - the count of one Icarus note for RH006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
2026-10-04 Phase 6: the third fit closes clk_sys at 50 MHz (+0.978 ns, TNS 0); resource ledger
    The architect's third compile of DE10_Nano_wpms, after PR #7: Formation
    RH006, switch RH003, clk_sys 30 % high.
    - STA: clk_sys setup +0.978 ns and TNS 0 at the Slow 1100 mV 0 C model;
    hold +0.042 ns; every clock meets. The fits so far: -14.307, -6.976,
    +0.978 ns.
    - The 10 worst endpoints are all MAC into w_hi, 18.8 ns of data delay.
    The estimate H2 (about 15 ns) had left out the opcode decode in front
    of the operand select (3.5 ns). The other groups of the second fit are
    not among the 10 worst (slack >= +1.547 ns).
    - clk_sys's minimum pulse width slack fell by 4.0 ns: the Fitter set the
    30 % duty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
2026-10-04 Phase 6: SW[1:0] = 11 (G = 12) before the captures; the board README said 00 by mistake
    The board README (section 2, 2026-10-01) told the architect to set
    SW[1:0] = 00. That is wrong: G = DIP[1:0] x 4, so 00 is G = 0. Every
    expected value assumes G = 12, which is SW[1:0] = 11: the models, the
    board bench (sw = 4'b0111), the expected captures and phase6_evidence.py.
    That is why the first sound and the capture ptsg_core_debug ran at G = 0,
    72 dB above the designed level.
    - de10_nano/README.md: section 2 (English and Japanese) says
    SW[1:0] = 11; a revision-history line records the correction.
    - phase6_templates.py RH002: each capture template gets a row for the
    switches. The templates in s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
    [phase6_templates.py]
2026-10-04 Phase 6: host script session fix; wpms_tap.stp committed and enabled; SD-23 adopted
    The architect's first run of a Phase 6 host script on the board (C2,
    wpms_phase6_full8_1008.tcl) stopped in wpms_open with "There is already
    an active In-System Sources and Probes session started". wpms_open
    started the session and then asked for the instance list, which Quartus
    refuses while a session is open.
    - wpms_issp_host.tcl RH002: the instance list is read first, then the
    session starts.
    - issp_standin.tcl RH002: as Quartus, no instance list and no second
    start while a session is open.
    - check_host_tcl.py RH003: a ninth mutant, the old order, is killed in
    every case. PASS, 9/9.
    SignalTap:
    - hw/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
    [wpms_tap.stp]
2026-10-04 Phase 6: wpms_tap.stp without its stored acquisition; stp_log_to_vcd.py for a failed export
    - wpms_tap.stp: the stored acquisition (a C5 trial, taken after its VCD
    export had failed) removed at the architect's word, since C5 will be
    taken again. The setup (nodes, depth, trigger) is unchanged; the display
    tree no longer points at a log. 2.2 MB -> 0.56 MB.
    - tools/stp_log_to_vcd.py (new): the acquisition stored in a saved .stp,
    written as the VCD SignalTap's export gives, so the saved .stp can
    stand in when the export fails. Each log is checked against its own
    trigger (the trial: tap_ctl[4] rises at sample 512, the T mark). The
    converted trial equals a direct decode in every bit,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
    [wpms_tap.stp]
2026-10-04 Phase 6: the SignalTap captures C1-C5 on the board, every measured value as expected
    The architect's captures of 2026-10-04 (50 MHz revision), one folder each
    in signaltap/2026-10-04_phase6_<capture>/: the export, the host log,
    observed.json (phase6_evidence.py) and observation.md, whose Expected
    columns are the templates' of 2026-10-01, unchanged.
    - C1 origin: T_wake 2, window 28 -> floor 30, BCP 2, full-load sweep
    1023, bundles 4/4, banks 4/4.
    - C2 full8: g 0, T_wake 2, floor 30, BCP of the full take-set 10,
    full-load sweep 1023, bundles 28/28, banks 3/3 (the first of the 4
    precedes the take). Equal to the architect's own report in every field;
    their .stp converts to the export bi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
2026-10-04 Phase 6: C3's storage qualifier, the C-major chord by ear, the SignalTap build's timing
    The architect's answers and files, later on 2026-10-04:
    - C3: the .stp saved after the capture (kept as C3_first_go.stp.gz,
    34 KB) holds the same log as the export, bit for bit.
    - SignalTap's own break marks are on samples 517, 1559, 1799 and
    3081. These are the four gaps, so the gaps come from the storage
    qualifier, which the architect enabled.
    - Its input was not the node tap_ctl[100]: 4082 of 4096 stored samples
    have tap_ctl[100] = 0. The .stp holds the port as a pin
    (storage_qualifier_port_is_pin="true"), so the qualifier most likely
    came from an extra input pin, which is as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
2026-10-14 OUTSIDE WPMS: host GUI — gui_board.md prepared; measure sets up four blocks
    The architect's answers of 2026-10-14:
    - gui_board.md is prepared with the expected column filled first.
    - A board session replayed in RTL-SIM must start at the test origin.
    - reports/gui_board.md: the procedure (P0-P6) and the expected values.
    - M0-M4, R1: scripted, by wpms_ctl.py measure.
    - S1-S8, R2: by hand and by ear in the GUI.
    - The rates are refined for this controller: the status poll of six
    reads every 250 ms shares the JTAG with the knobs. Master gain is
    expected at 19-179 /s and block-level GOs at 4-36 /s, for one ISSP
    transaction of 30-5 ms. One APPLIED_SEQ poll per GO.
    - wpms_ctl.py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
2026-10-15 OUTSIDE WPMS: host GUI — the board run of 2026-10-15 (SILICON)
    The architect ran gui_board.md P2 (wpms_ctl.py measure) and P3 (the GUI by
    hand and by ear) on the DE10-nano.
    - One ISSP transaction: 0.41 ms mean, 3.5 ms max over 1,000 reads; 92.8 %
    under 0.5 ms over 132,831. The brief estimated 5-30 ms.
    - Master gain: 1,826 updates/s.
    - Block level on four blocks: 374 GOs/s, 0.992 APPLIED_SEQ polls per GO.
    - REJECT[0] stayed 0 throughout; no refusal, ISSP error or CLIP.
    - By ear: no clicks, no zipper noise. PANIC reached -72 dB at 1.22 s and
    the floor at 3.28 s (60 dB/s).
    - The GUI session replayed in RTL-SIM: PASS (2,808 GOs, 0 host writes
    refused, 9,571 / 9,571 samples equal the mod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
2026-10-15 OUTSIDE WPMS: host GUI — the GUI session's replay report regenerated (origin flag printed as True)
    Claude-Session: https://claude.ai/code/session_012YNpjdQnftAn1t5Ed7fzo3
2026-10-15 OUTSIDE WPMS: host GUI — the scripted board session replays clean in RTL-SIM (R1)
    board_measure.json, 155,283 steps, through wpms_system with cosim_switch.py's
    checks: PASS.
    - 22,450 GOs, all accepted by the RTL; 0 host writes refused of 85,664.
    - APPLY with APPLIED_SEQ = GO_SEQ: 22,450 / 22,450.
    - GO -> play from strobe 2.
    - 263,418 transactions equal switch_model's.
    - 67,816 / 67,816 samples equal the models.
    gui_board.md row R1 and the Layer 4 README row filled; both board sessions
    are now green.
    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
2026-10-18 OUTSIDE WPMS: host GUI — the architect's answers, screenshot and recording of 2026-10-18
    - S7: SignalTap was closed throughout. Q1: the slider was not moved back
    after PANIC, so the log is complete.
    - S8: screenshot of a later session (all eight blocks, Σ N = 1,008 /
    1,008, REJECT[0] +0, ISSP 0.80 / 4.18 ms mean / max over 7,300).
    - Recording (FLAC, lossless from the WAV; logs/recording_analysis.py):
    - peak -21.3 dBFS; the eight notes C3...C6;
    - each block's main lobe returns every 16.00 s = 1/(1/16 Hz);
    - a 250 Hz comb (750 Hz at -57 dBFS) between the bursts: identical in L
    and R, independent of the music; outside the WPMS samples by the
    evidence so far.
    - Q4 asks for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
2026-10-18 OUTSIDE WPMS: host GUI — Q4 settled: the recording noise is the HDMI audio splitter's
    The architect's test of 2026-10-18 settles where the 250 Hz comb comes from.
    - It stays the same with soft mute (SW[3] = 1), through a reset, and with
    HDMI unplugged.
    - On an oscilloscope it lies around 1 MHz.
    - It halves when the splitter's USB-C power comes from a separate AC adapter.
    - Recording chain: HDMI -> inexpensive HDMI audio splitter -> Zoom H4n Pro
    analog input -> USB -> Cubase.
    The noise is outside WPMS. Nothing changes in the design or the tools, and
    no question is open. gui_board.md §4.5-§4.6 and the Layer 4 README row are
    updated.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
2026-10-18 OUTSIDE WPMS: host GUI — start_wpms.bat, the architect's one-click launcher for Windows
    Launcher v2 by the architect. It finds Python 3.8+ with Tkinter and
    quartus_stp.exe, starts wpms_bridge.tcl or reuses a running bridge after a
    PING, and then opens wpms_gui.py --connect. Its logs go to wpms_logs\.
    Added with:
    - a house-format rem header (MIT, revision history);
    - socket timeouts caught as socket.timeout as well (before Python 3.10
    that is an OSError, not TimeoutError);
    - gui/.gitattributes (*.bat eol=crlf) and gui/.gitignore (wpms_logs/);
    - a README section.
    The Python part compiles. Run on Linux, it stops with its Windows-only
    message after creating its log folder.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
2026-10-19 OUTSIDE WPMS: host lab — Phase A begun: lab_shapes.py, V-L1 PASS; stopped for the architect
    LAB_BRIEF_WPMS_Sound_Design_2026-10-19. Nothing in gui/ is changed.
    - reports/lab_v1.md: the expected values were written first. Now
    recorded: V-L1 results, the proposed seam, deviation D1, and
    questions Q1-Q4.
    - lab/lab_shapes.py: pure conversions.
    - chirp -> OMD2;
    - PH0/PHD1/PHD2: lobe offset tau, Schroeder, Half-Schroeder;
    - window: peak position, width, offset, raw mode;
    - headroom and band indicators.
    - lab/test_lab.py V-L1 against the customer's oracle: 11/11 PASS.
    - Schroeder identity exact; the oracle's words at N = 2048.
    - lobe offset to the sample; crest 26.81 / 7.53 / 5.6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
2026-10-19 OUTSIDE WPMS: host lab — L4.3: board_gui.json replays PASS as on 2026-10-15 (run while the seam was applied locally)
    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
2026-10-19 OUTSIDE WPMS: host lab — the seam in gui/wpms_ctl.py (RH003, ruling 2026-10-19)
    slots_of(b) returns block_slots(self.params[b]), and the sender's two calls
    (_block_mask, _send_item) go through it. Nothing else in gui/ changes, and
    the GUI's behaviour is unchanged:
    - V1 PASS, 9/9 mutants;
    - V2 PASS; the deterministic V2 storm log is identical with and without
    the seam;
    - check_host_tcl PASS;
    - board_gui.json (2026-10-15) replays PASS with the same numbers.
    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
2026-10-19 OUTSIDE WPMS: host lab — WPMS Lab Phase A: controller, panel, presets, launcher; V-L1...V-L4 PASS
    LAB_BRIEF_WPMS_Sound_Design_2026-10-19, with the rulings of 2026-10-19:
    - the window's peak position p maps to k_c = p N, so p = 0.5 is the GUI's
    window bit for bit;
    - own risk: indicators only; LE0 < 0 (EW6) is refused; the switch's rules
    are kept;
    - Dirichlet scale has N = 126 per block.
    hw/tools/host/lab/:
    - wpms_lab_ctl.py: subclass of the GUI's Controller. It overrides
    slots_of, the desired-state checks, phase seeding ("pending seed" until
    Seed) and presets (JSON; the knobs and the resolved slots; a load goes
    through the normal sender).
    - wpms_lab.py: the GUI's panel (imported)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
